nils-eilers/kolibri/README.md

kolibri
=======

About
-----

kolibri is an 8 bit homebrew computer project, based on the 6309 CPU by
Hitachi, a kind of advanced edition of the much more famous CPU 6809 by
Motorola.

kolibri is the german word for colibri aka hummingbird.
