nils-eilers/kolibri/software/i8742/README.md

8742 keyboard and mouse controller for kolibri
==============================================

Assemble with The Macroassembler AS, freely available from http://john.ccac.rwth-aachen.de:8000/as/

Based on disassembly of 72x8455.zm82.bin

Commented disassembly of the PS/2 keyboard/auxiliary device controller 8042
2KB ROM by A. Tarpai 2018 (Questions & comments are welcome to tarpai76 at gmail)

The original file has been downloaded from http://www.halicery.com/8042/8042_PS2_INTERN.TEXT
