nils-eilers/kolibri/doc/jtag-chain.png

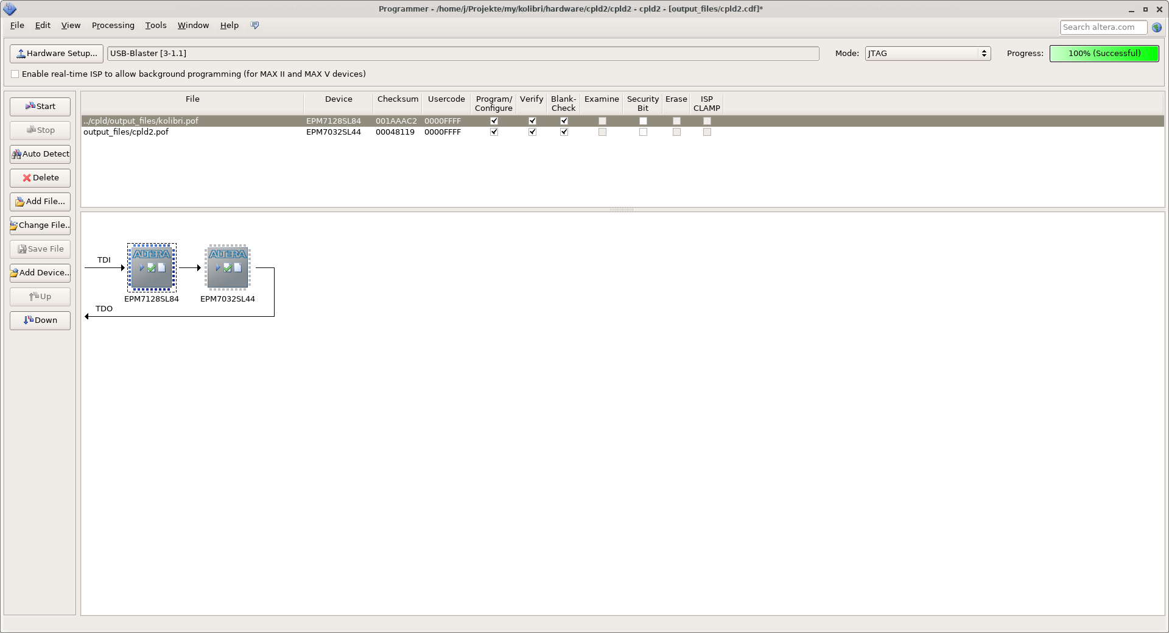
doc/jtag-chain.png
