nils-eilers/kolibri/doc/manual/bios.tex

\chapter{BIOS}

\section{Introduction}

The BIOS functions are called via software interrupt {\bf SWI}.
Input and output parameters are transferred via registers.
The contents of all registers are retained, except those,
which are used to return values.

Register {\bf B} is loaded with the BIOS function number.
Never use numeric values to load the {\bf B} register.
Use the symbolic names, as defined in the file
"kolibri-definitions.as9".

If more byte values are needed as input, the registers
{\bf A}, {\bf E} and {\bf F} may be used.
16-bit values or addresses can be loaded into the registers
{\bf X} or {\bf Y}.

If the number of parameters exceeds the number of available
registers, the address of a structure should be passed.

Examples:
\begin{verbatim}

*       print the character 'A'

        LDB   #SCR_Put_Char
        LDA   #'A'
        SWI

*       print a zero terminated string

        LDB   #SCR_Put_String
        LDX   #Message
        SWI

*       Read a character from keyboard

        LDB   #KBD_Get_Key
        SWI
*             Register A now contains an ASCII value
*             or NULL, if no key was read
        RTS

Message BYTE "Kolibri welcomes you\n",0

\end{verbatim}
