nils-eilers/kolibri/doc/manual/frontcover.tex

\begin{titlepage}
\begin{center}
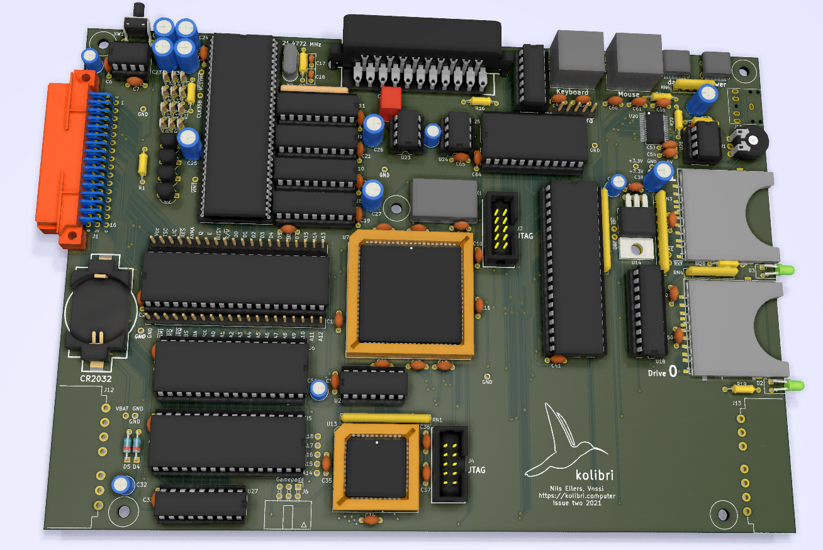
[picture p2: doc/manual/images/cover.png]

\end{center}
\end{titlepage}
