nils-eilers/kolibri/doc/manual/images/cpld-jtag-programming.png

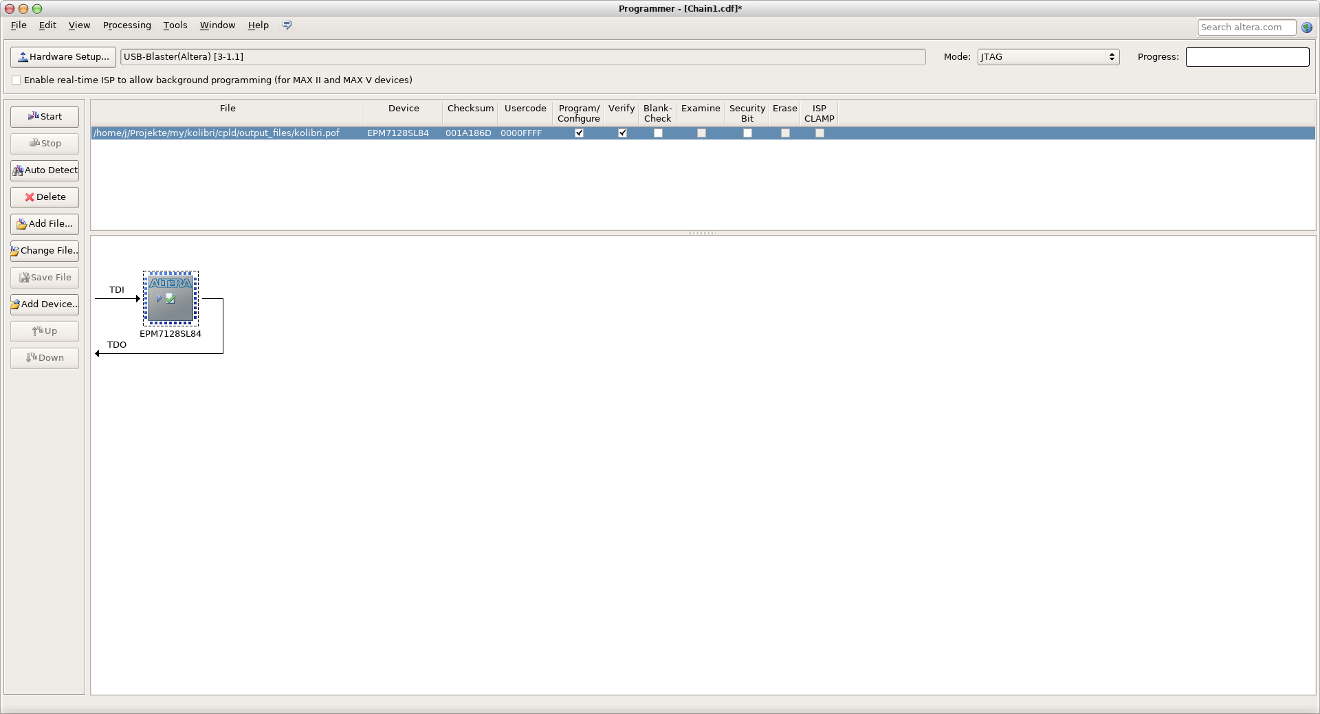
doc/manual/images/cpld-jtag-programming.png
