nils-eilers/kolibri/doc/manual/images/mini.jpg

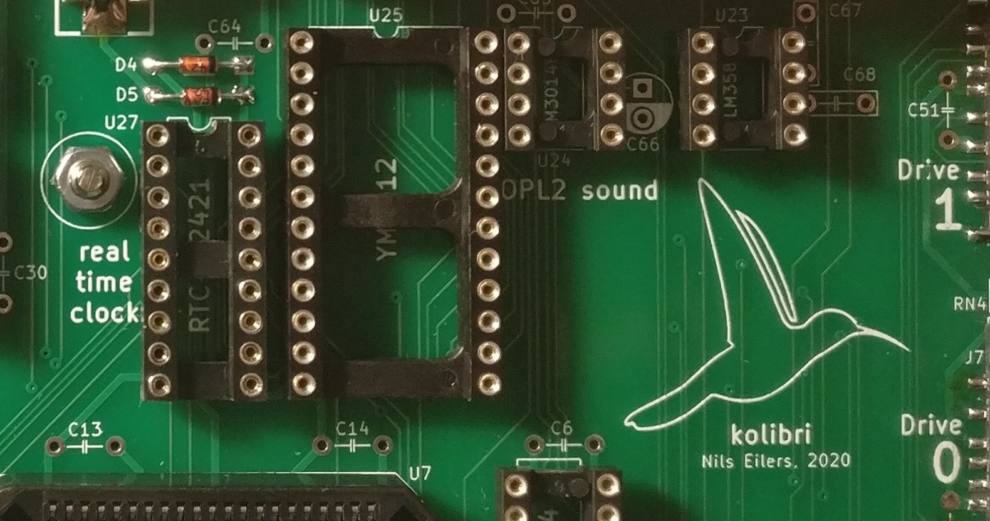
doc/manual/images/mini.jpg
