nils-eilers/kolibri/doc/kolibri-issue-three-schematics.pdf

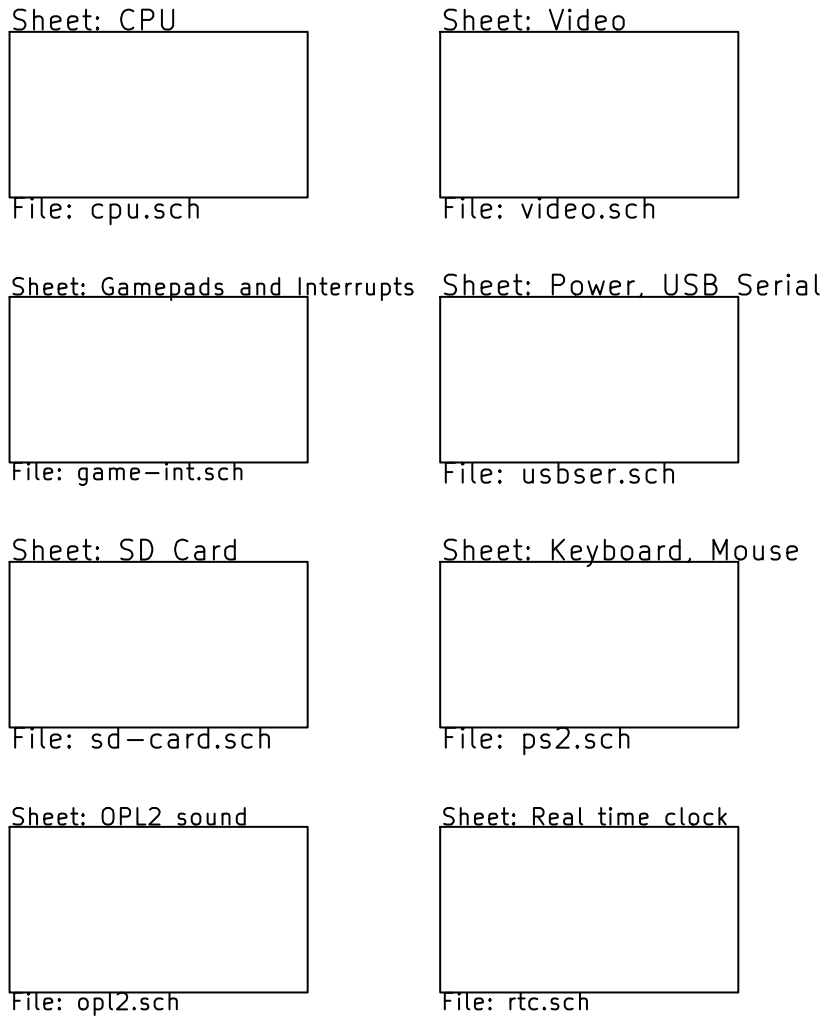
[picture p14: page 1]

File: game-int.sch

Id: 1/9 Title: kolibri File: main.sch Sheet: / nils.eilers@gmx.de

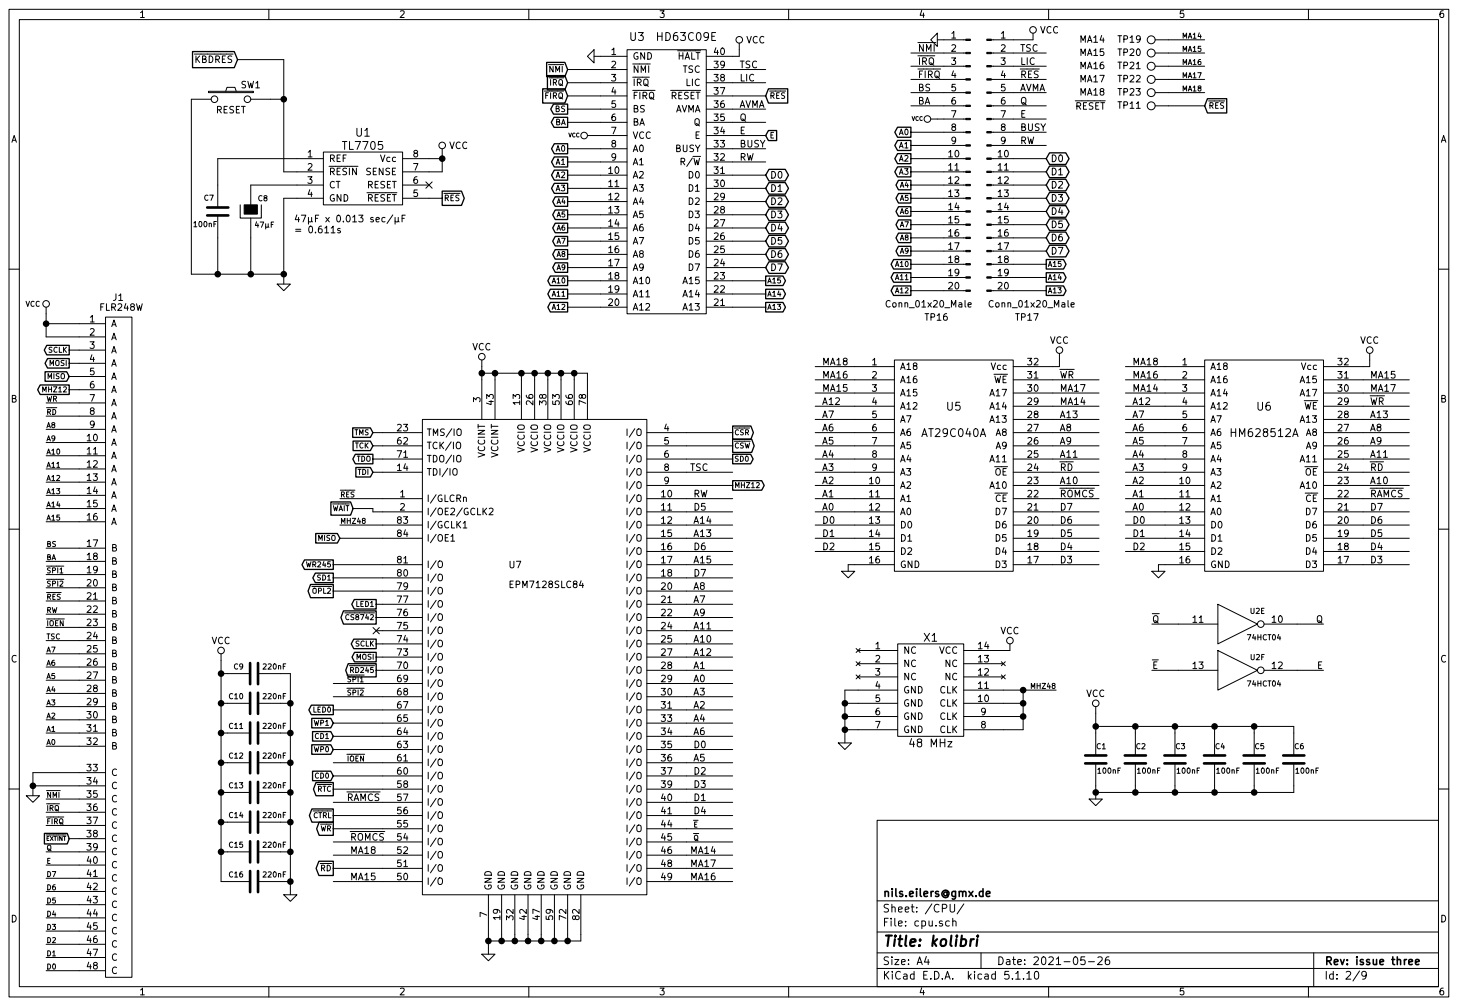
[picture p15: page 2]

File: cpu.sch Sheet: /CPU/ nils.eilers@gmx.de

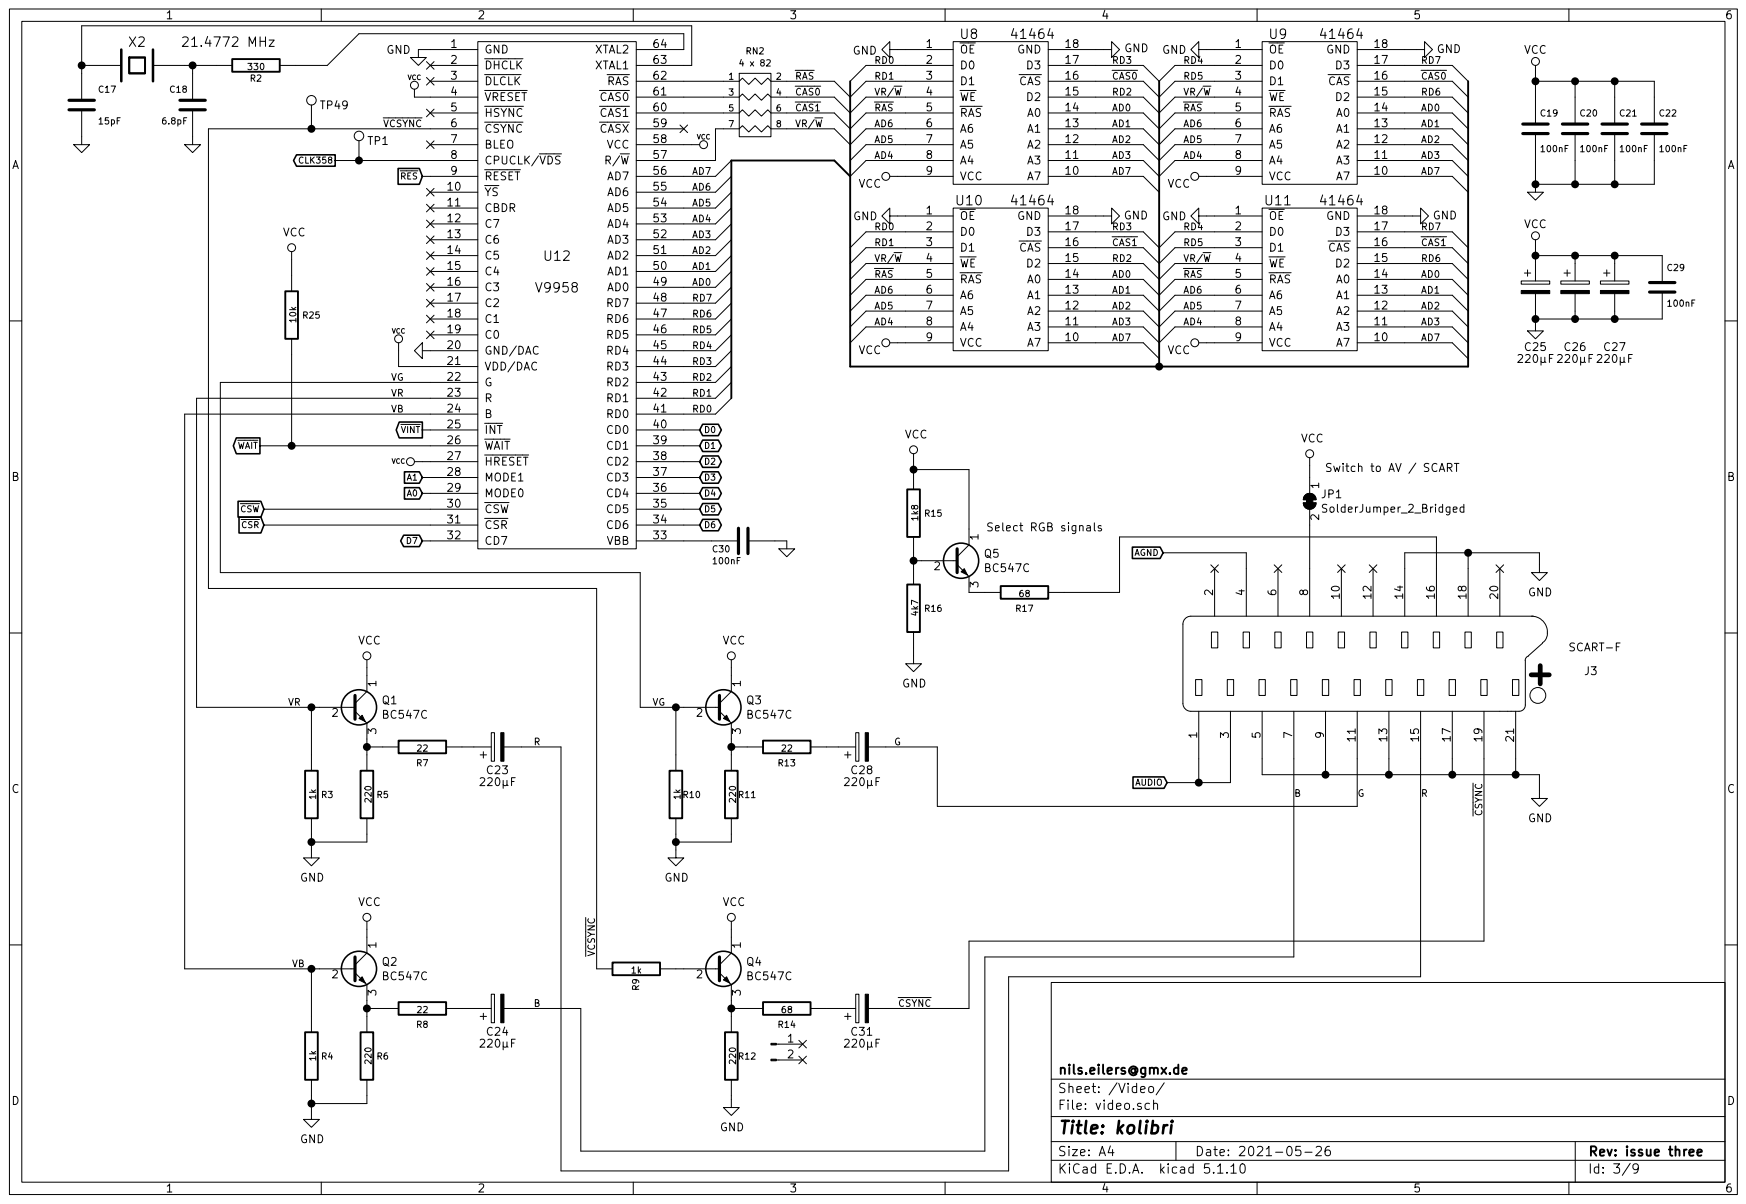
[picture p16: page 3]

VR
VB 24

Id: 3/9 Title: kolibri File: video.sch Sheet: /Video/ nils.eilers@gmx.de

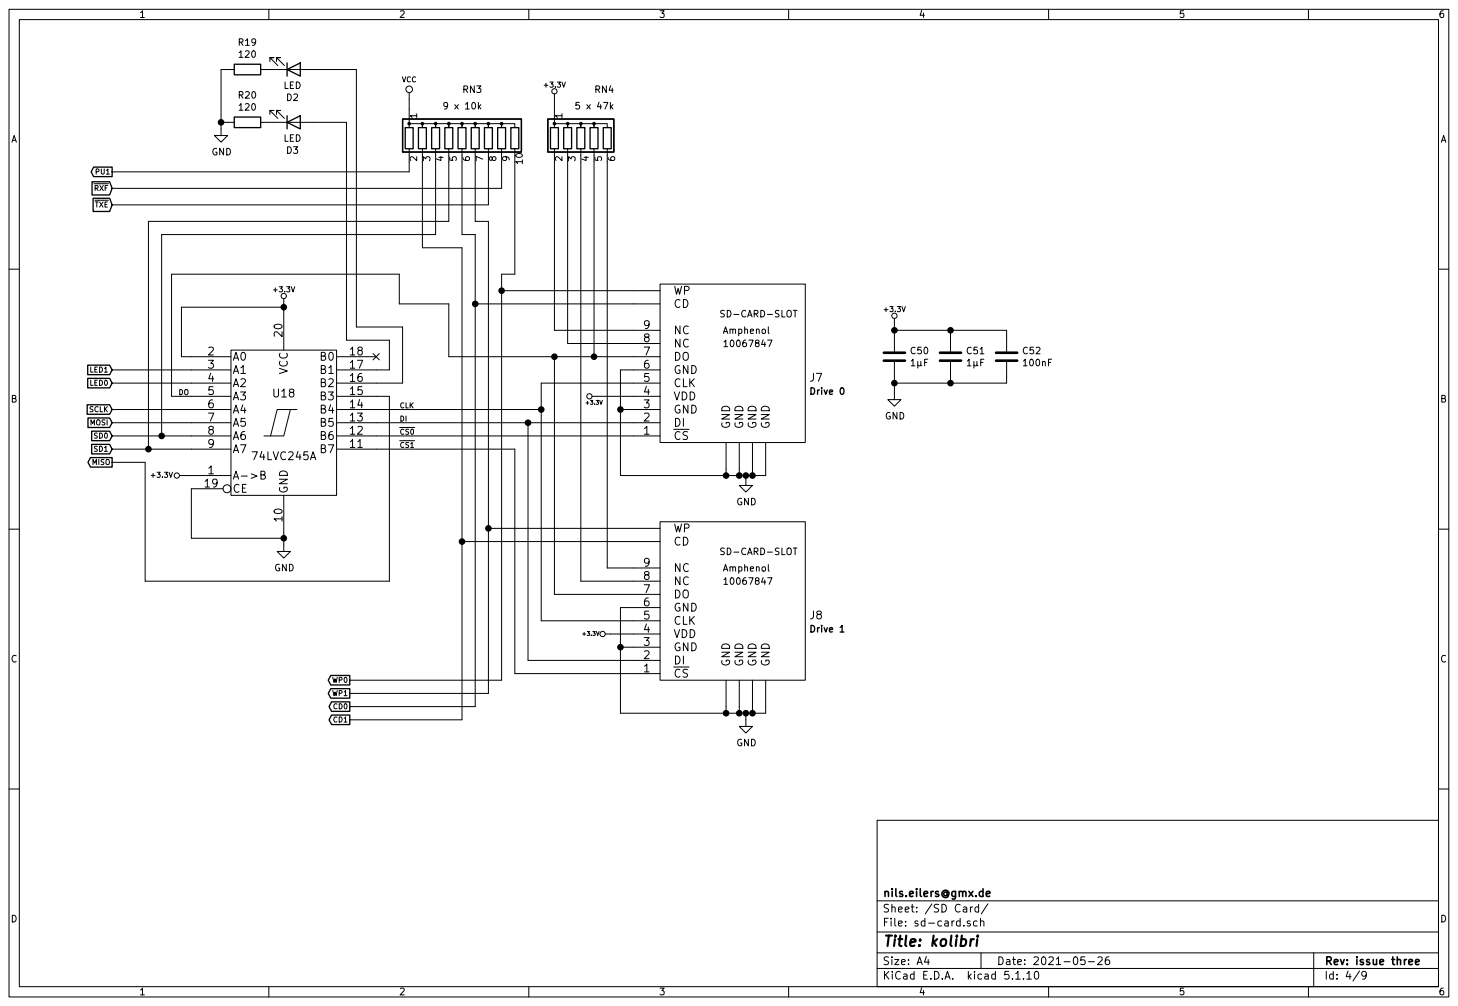
[picture p17: page 4]

Id: 4/9 Title: kolibri File: sd-card.sch Sheet: /SD Card/ nils.eilers@gmx.de

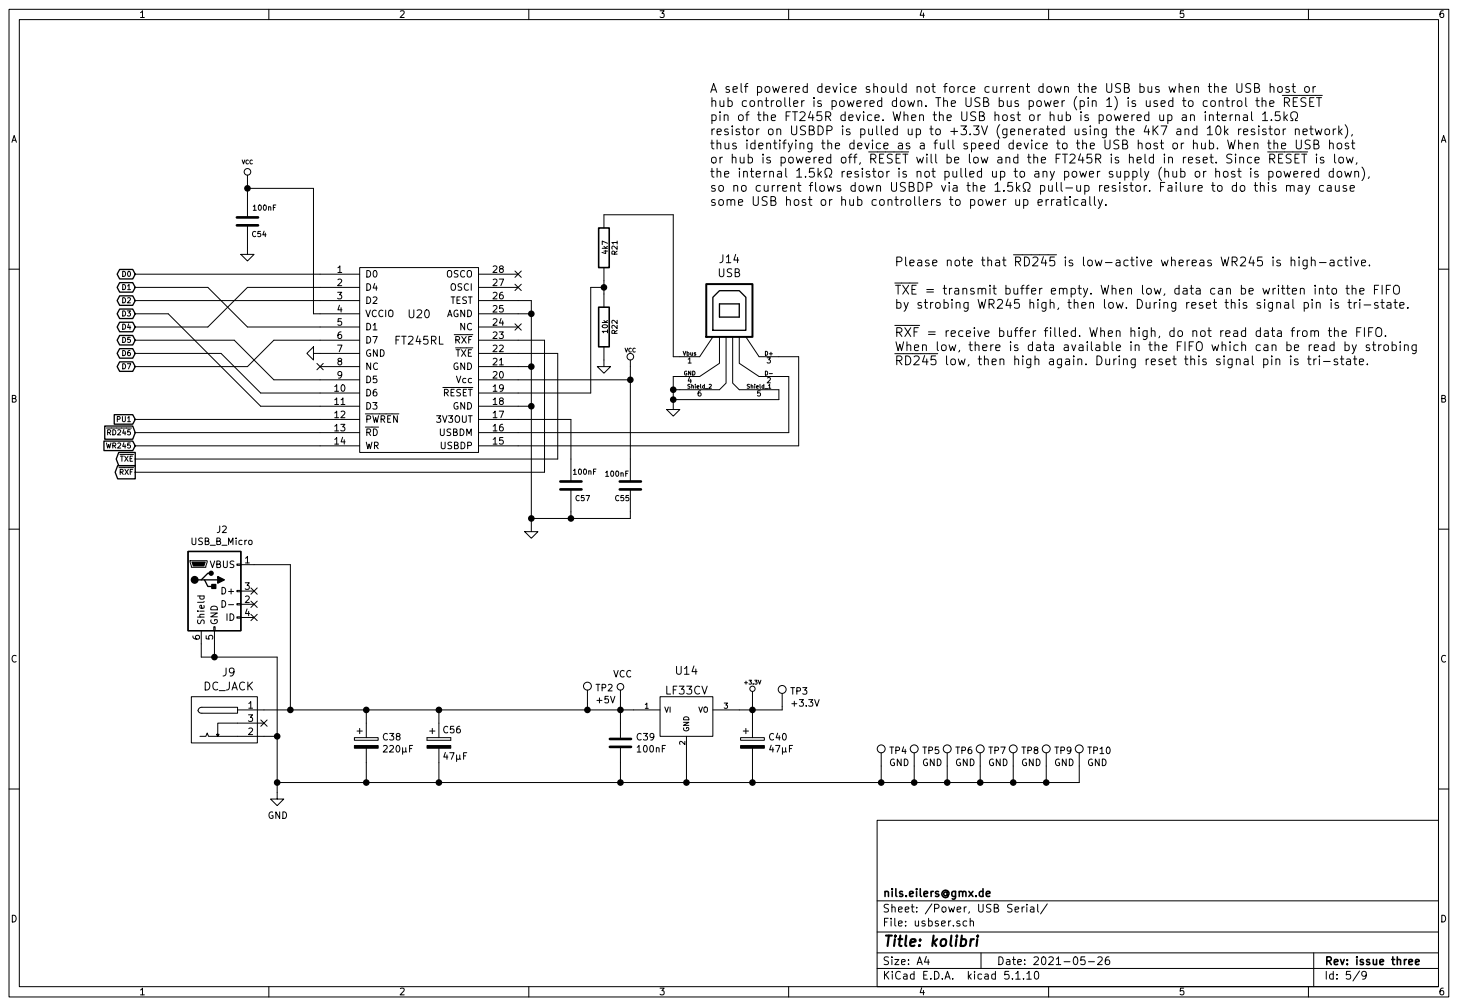
[picture p18: page 5]

hub controller is powered down. The USB bus power (pin 1) is used to control the RESET
pin of the FT245R device. When the USB host or hub is powered up an internal 1.5k
resistor on USBDP is pulled up to +3.3V (generated using the 4K7 and 10k resistor network),
thus identifying the device as a full speed device to the USB host or hub. When the USB host
or hub is powered off, RESET will be low and the FT245R is held in reset. Since RESET is low,
the internal 1.5k resistor is not pulled up to any power supply (hub or host is powered down),
so no current flows down USBDP via the 1.5k pull-up resistor. Failure to do this may cause
some USB host or hub controllers to power up erratically.

Please note that RD245 is low-active whereas WR245 is high-active.

TXE = transmit buffer empty. When low, data can be written into the FIFO
by strobing WR245 high, then low. During reset this signal pin is tri-state.

RXF = receive buffer filled. When high, do not read data from the FIFO.
When low, there is data available in the FIFO which can be read by strobing
RD245 low, then high again. During reset this signal pin is tri-state.

nils.eilers@gmx.de C56

Id: 5/9 Title: kolibri File: usbser.sch Sheet: /Power, USB Serial/

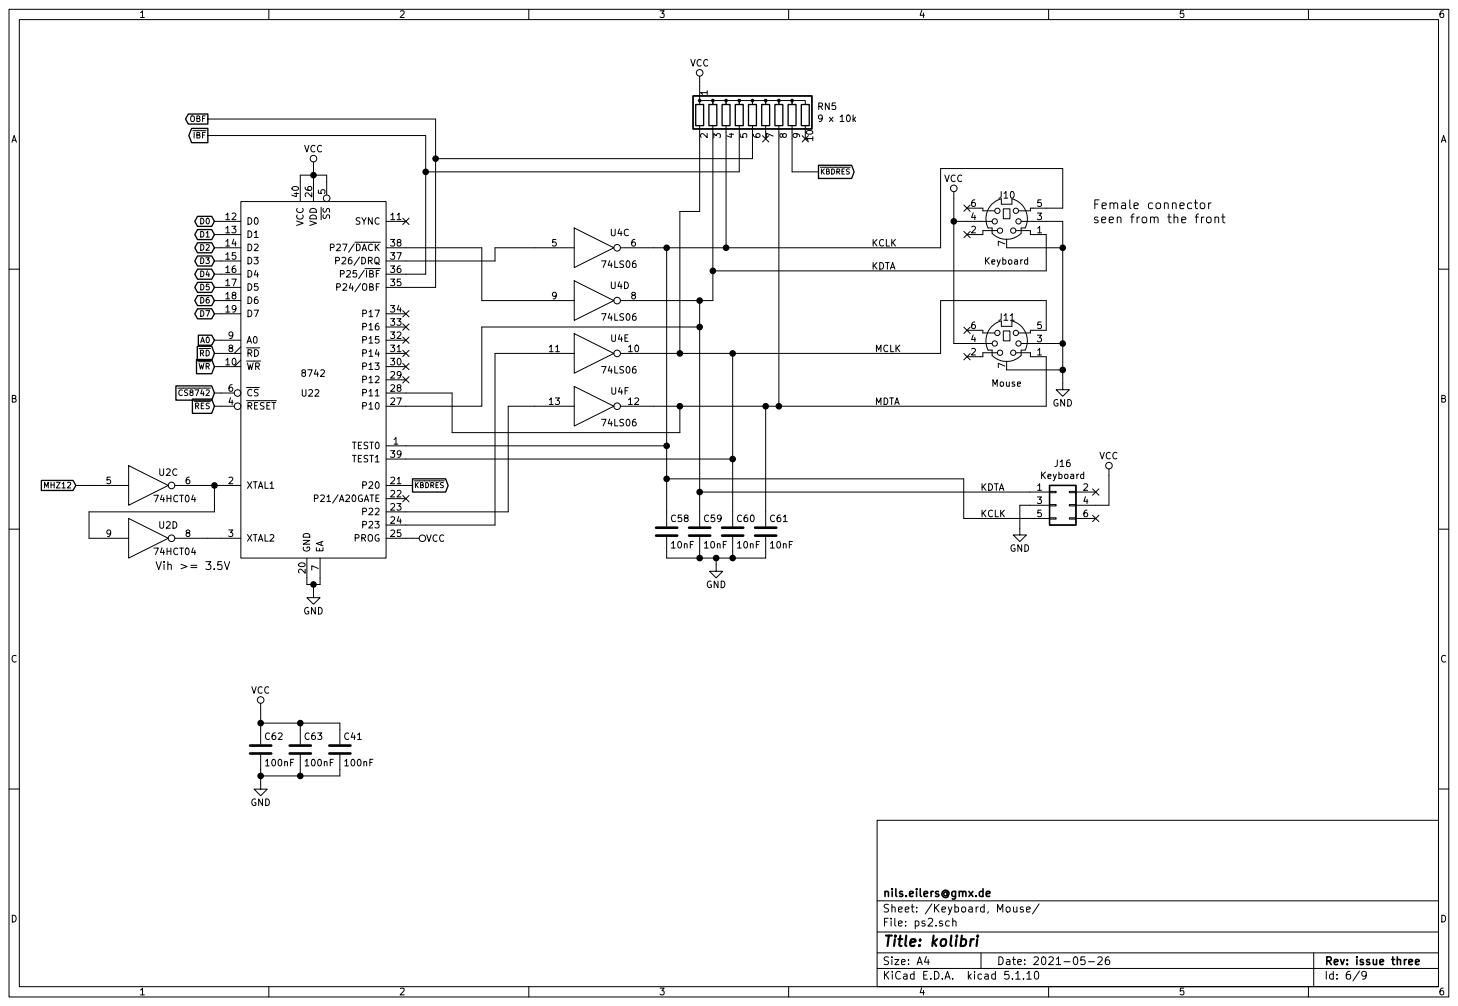
[picture p19: page 6]

seen from the front Vih >= 3.5V
KBDRES D0 CS8742

nils.eilers@gmx.de GND GND

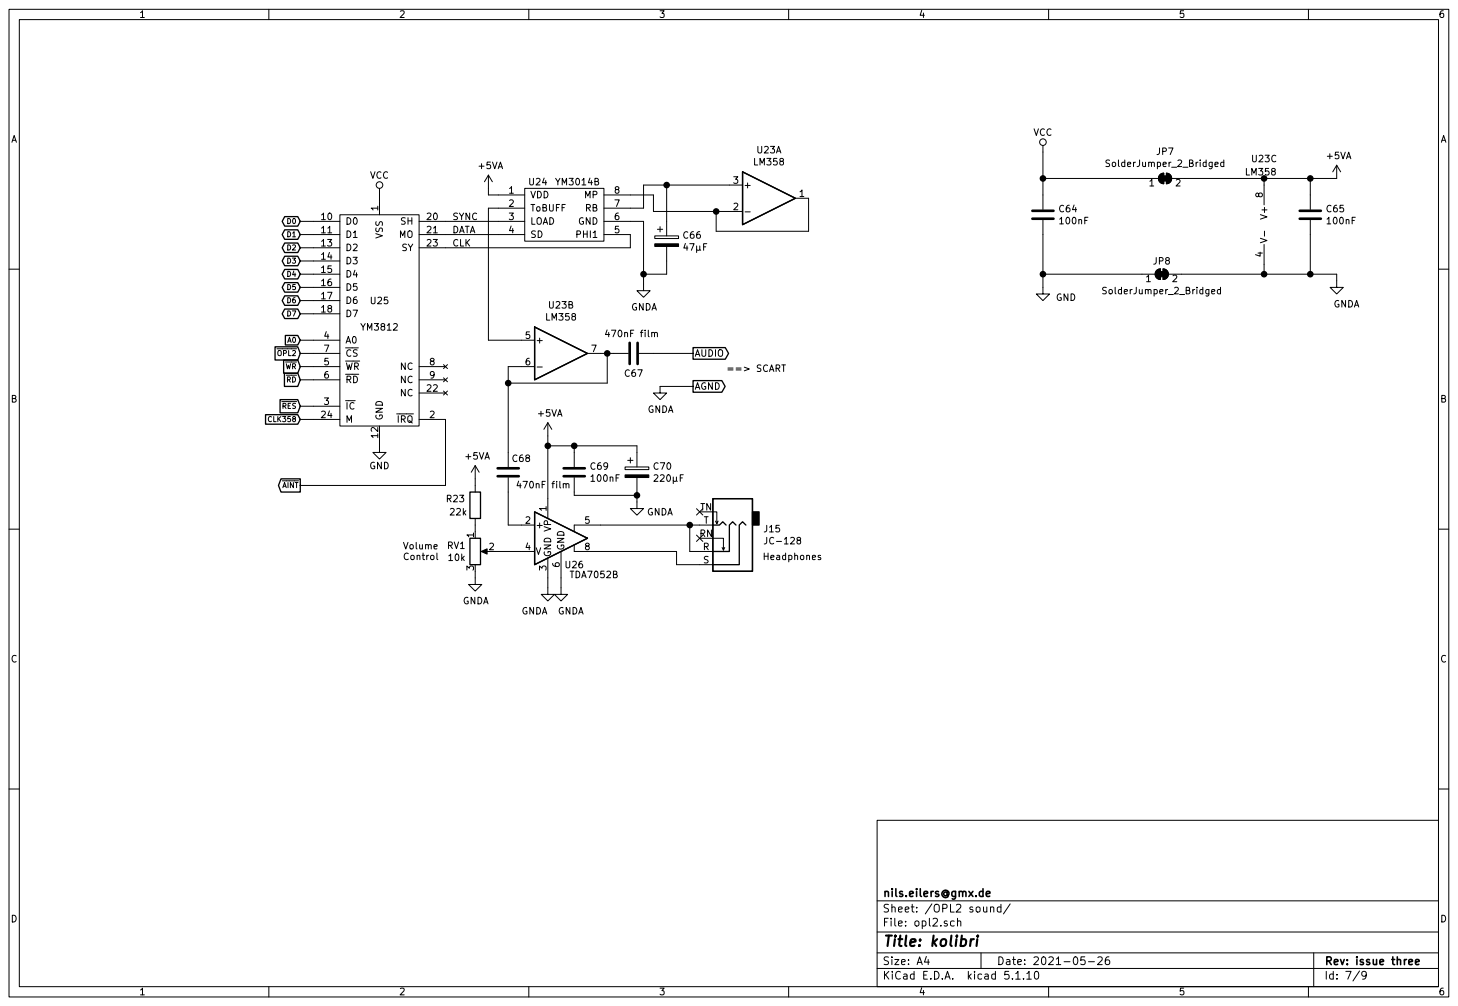
[picture p20: page 7]

File: opl2.sch Sheet: /OPL2 sound/ nils.eilers@gmx.de R

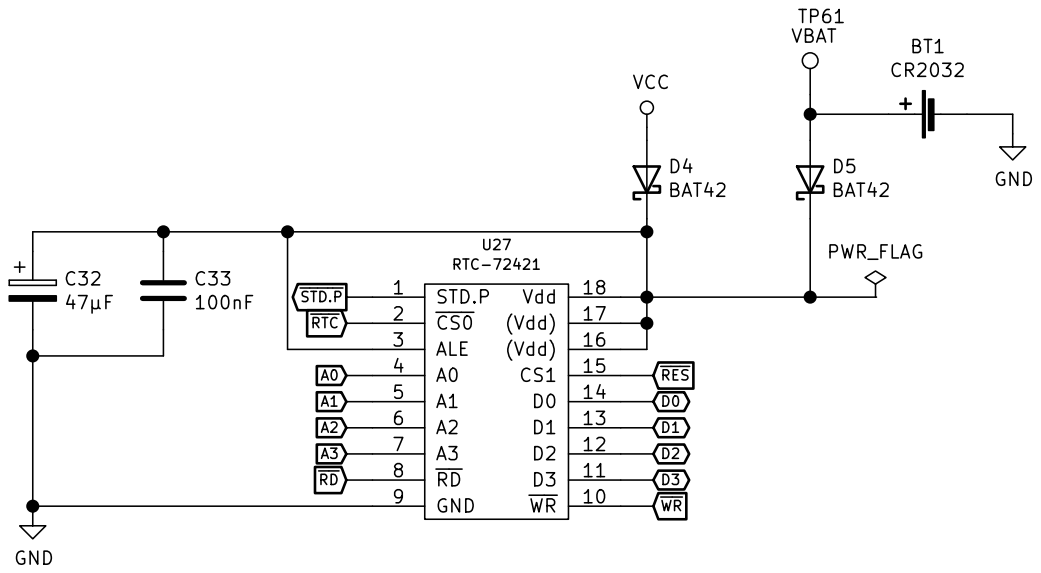
[picture p21: page 8]

Id: 8/9 Title: kolibri File: rtc.sch Sheet: /Real time clock/ nils.eilers@gmx.de

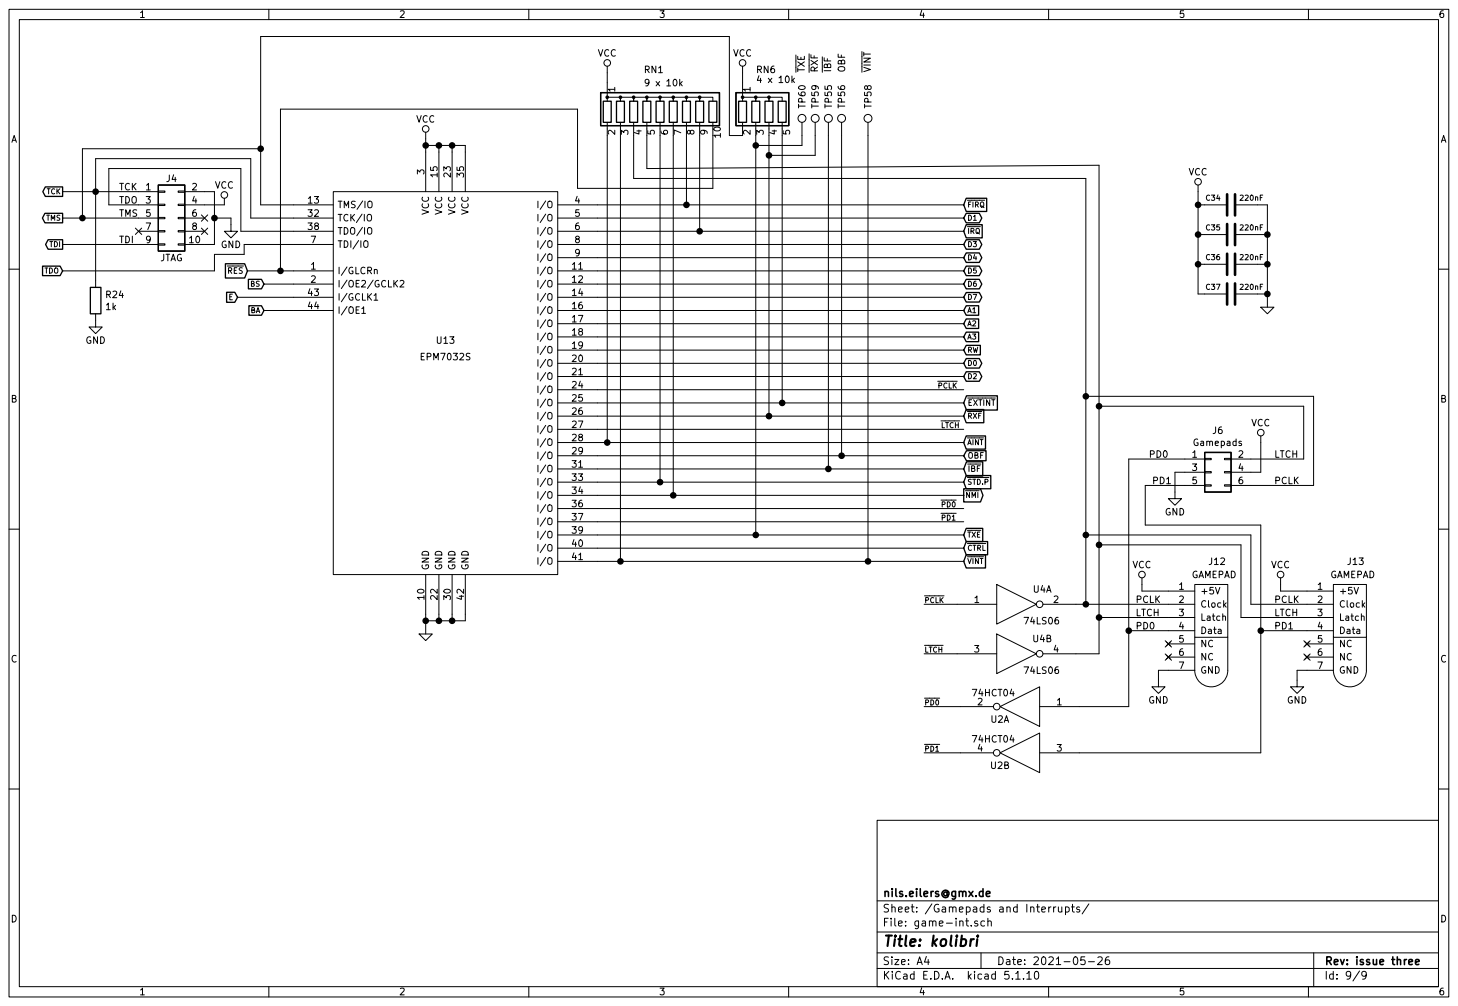
[picture p22: page 9]

nils.eilers@gmx.de
Sheet: /Gamepads and Interrupts/
File: game-int.sch
Id: 9/9 Title: kolibri
