nils-eilers/kolibri/hardware/kicad/main.kicad_pcb

## KiCad design hardware/kicad/main.kicad_pcb (2021-05-25)

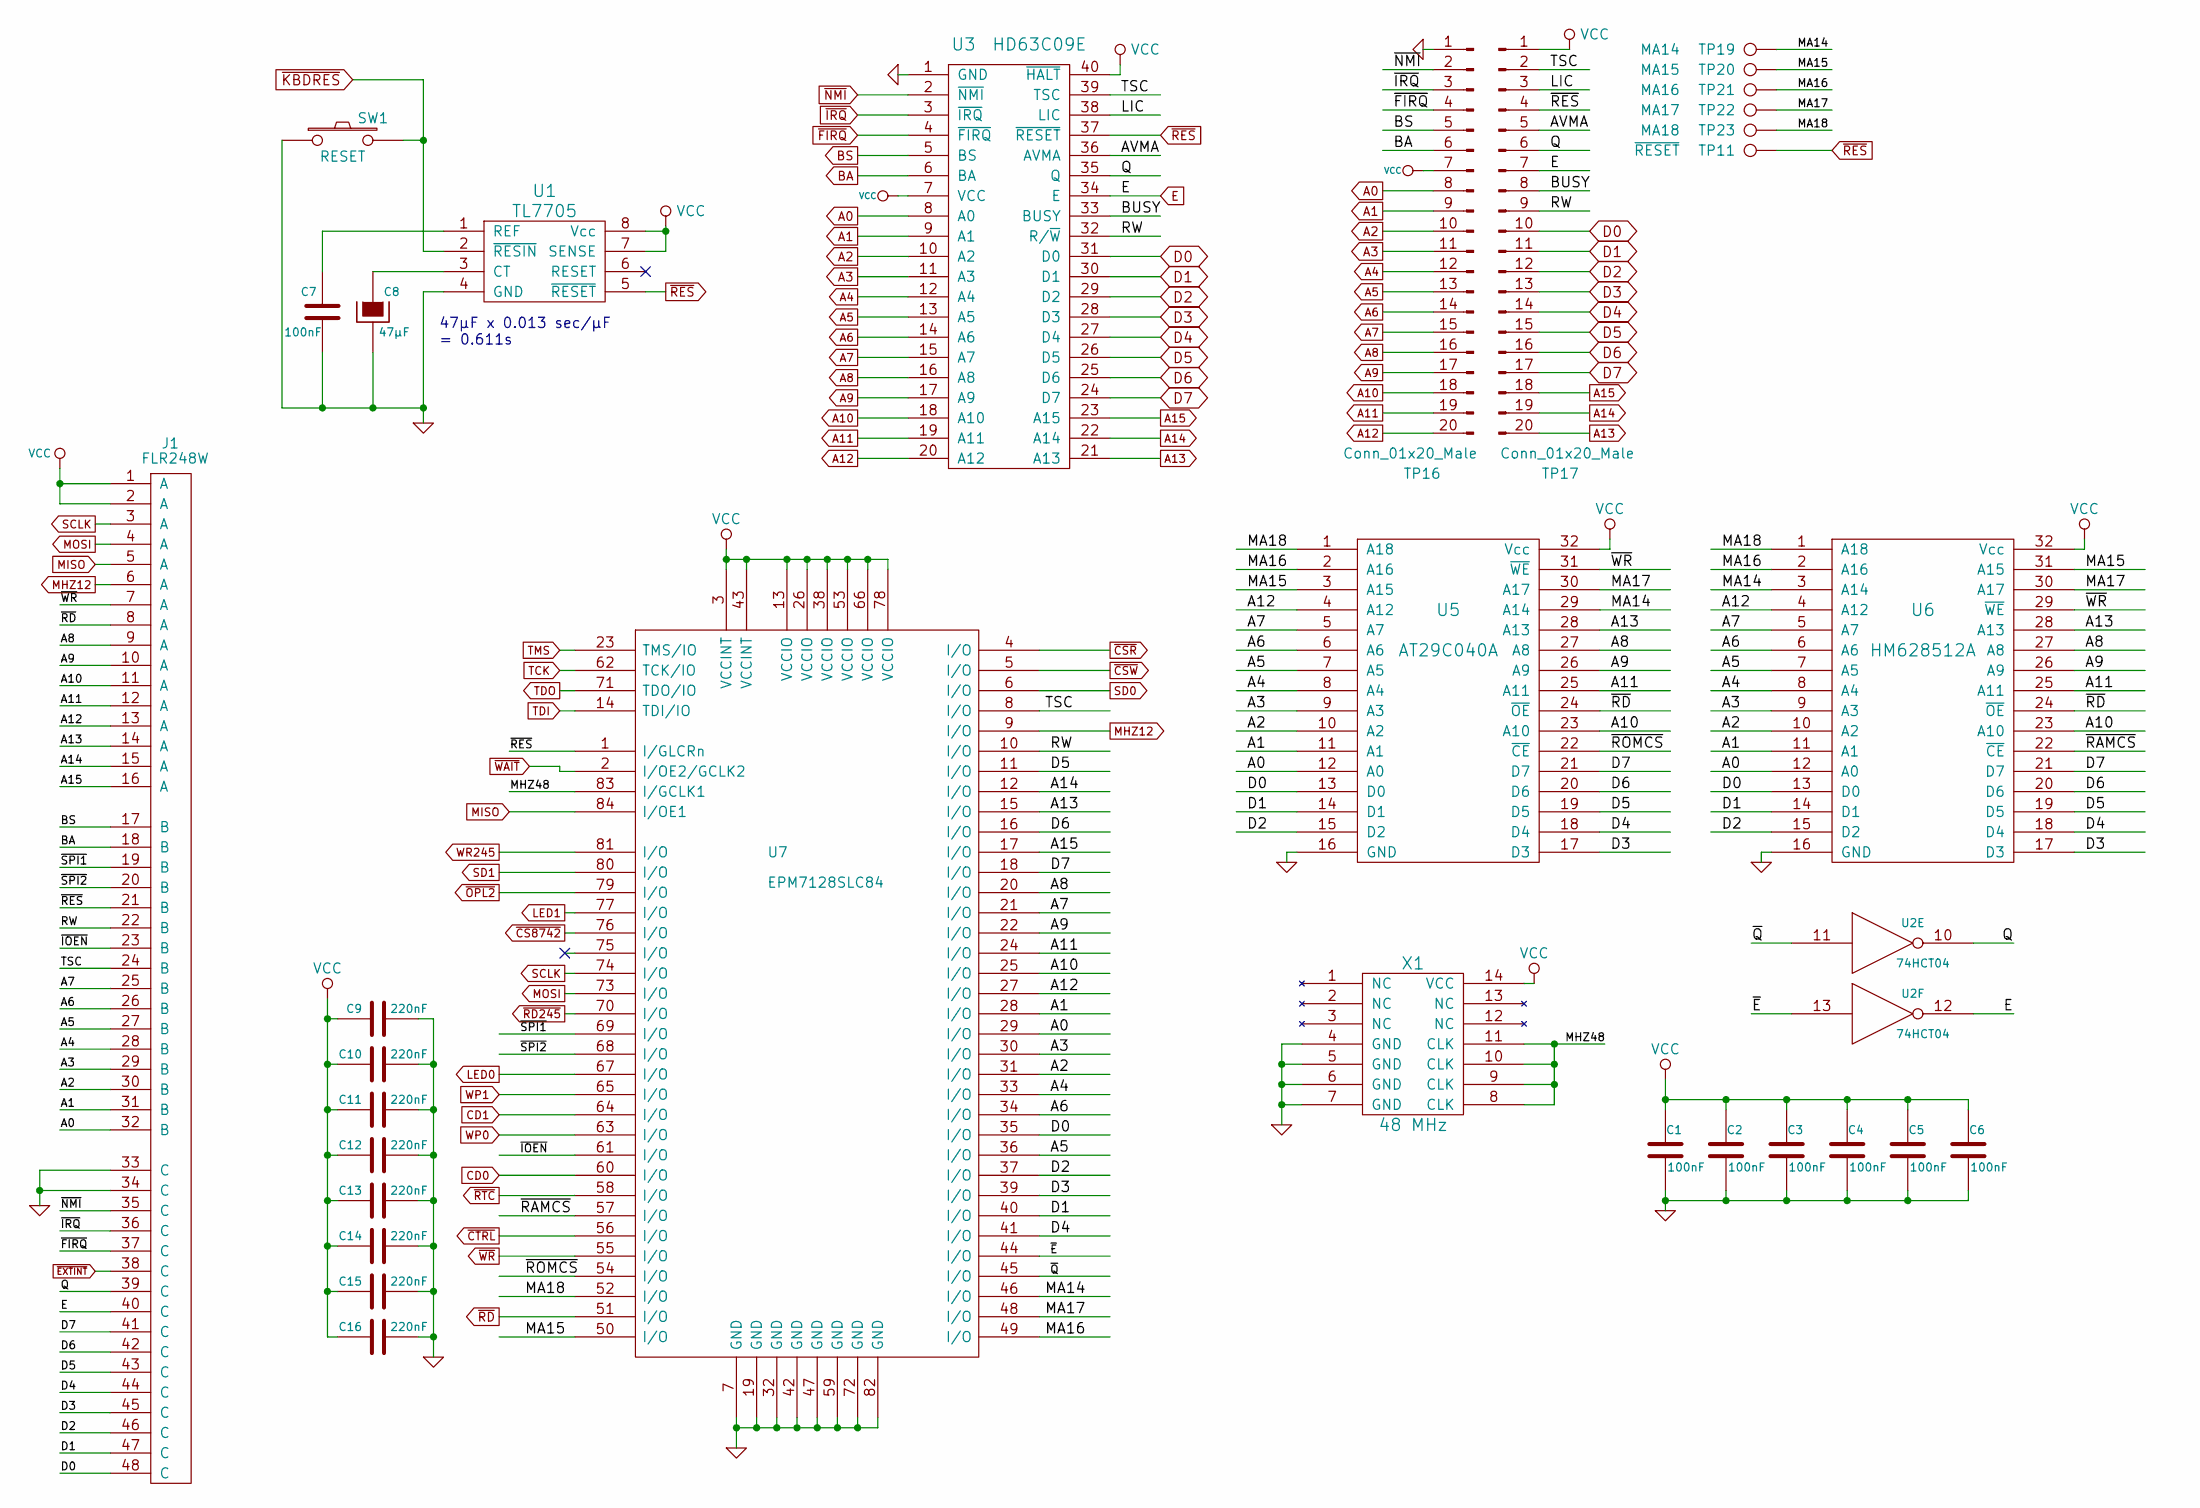
[picture p23: schematic cpu.sch, https://kolibri.computer]

Parts:
C1, C2, C3, C4, C5, C6, C7: 100nF; KERKO-5
C8: 47µF; CP-2-5
C9, C10, C11, C12, C13, C14, C15, C16: 220nF; KERKO-5
J1: FLR248W; FL-R2-48W
SW1: RESET; TASTER_3305
TP11: ~RESET; PINTST
TP16, TP17: Conn_01x20_Male; Pin_Header_Straight_1x20_Pitch2.54mm
TP19: MA14; PINTST
TP20: MA15; PINTST
TP21: MA16; PINTST
TP22: MA17; PINTST
TP23: MA18; PINTST
U1: TL7705; DIP-8
U2: 74HCT04; DIP-14
U3: HD63C09E; DIP-40
U5: AT29C040A; DIP-32
U6: HM628512A; DIP-32
U7: EPM7128SLC84; PLCC-84
X1: 48 MHz; OSC

Connections:
/CPU/AVMA: TP17.5, U3.36 (AVMA)
/CPU/BUSY: TP17.8, U3.33 (BUSY)
/CPU/LIC: TP17.3, U3.38 (LIC)
/CPU/MA14: TP19.1, U5.29 (A14), U6.3 (A14), U7.46 (I/O)
/CPU/MA15: TP20.1, U5.3 (A15), U6.31 (A15), U7.50 (I/O)
/CPU/MA16: TP21.1, U5.2 (A16), U6.2 (A16), U7.49 (I/O)
/CPU/MA17: TP22.1, U5.30 (A17), U6.30 (A17), U7.48 (I/O)
/CPU/MA18: TP23.1, U5.1 (A18), U6.1 (A18), U7.52 (I/O)
/CPU/MHZ48: U7.83 (I/GCLK1), X1.8 (CLK), X1.9 (CLK), X1.10 (CLK), X1.11 (CLK)
/CPU/Q: J1.39 (C), TP17.6, U2.10, U3.35 (Q)
/CPU/RW: J1.22 (B), TP17.9, U3.32 (R/~W), U7.10 (I/O)
/CPU/TSC: J1.24 (B), TP17.2, U3.39 (TSC), U7.8 (I/O)
/CPU/~E: U2.13, U7.44 (I/O)
/CPU/~IOEN: J1.23 (B), U7.61 (I/O)
/CPU/~Q: U2.11, U7.45 (I/O)
/CPU/~RAMCS: U6.22 (~CE), U7.57 (I/O)
/CPU/~ROMCS: U5.22 (~CE), U7.54 (I/O)
/CPU/~SPI1: J1.19 (B), U7.69 (I/O)
/CPU/~SPI2: J1.20 (B), U7.68 (I/O)
A0: J1.32 (B), TP16.8, U3.8 (A0), U5.12 (A0), U6.12 (A0), U7.29 (I/O); also elsewhere on the board
A1: J1.31 (B), TP16.9, U3.9 (A1), U5.11 (A1), U6.11 (A1), U7.28 (I/O); also elsewhere on the board
A2: J1.30 (B), TP16.10, U3.10 (A2), U5.10 (A2), U6.10 (A2), U7.31 (I/O); also elsewhere on the board
A3: J1.29 (B), TP16.11, U3.11 (A3), U5.9 (A3), U6.9 (A3), U7.30 (I/O); also elsewhere on the board
A4: J1.28 (B), TP16.12, U3.12 (A4), U5.8 (A4), U6.8 (A4), U7.33 (I/O)
A5: J1.27 (B), TP16.13, U3.13 (A5), U5.7 (A5), U6.7 (A5), U7.36 (I/O)
A6: J1.26 (B), TP16.14, U3.14 (A6), U5.6 (A6), U6.6 (A6), U7.34 (I/O)
A7: J1.25 (B), TP16.15, U3.15 (A7), U5.5 (A7), U6.5 (A7), U7.21 (I/O)
A8: J1.9 (A), TP16.16, U3.16 (A8), U5.27 (A8), U6.27 (A8), U7.20 (I/O)
A9: J1.10 (A), TP16.17, U3.17 (A9), U5.26 (A9), U6.26 (A9), U7.22 (I/O)
A10: J1.11 (A), TP16.18, U3.18 (A10), U5.23 (A10), U6.23 (A10), U7.25 (I/O)
A11: J1.12 (A), TP16.19, U3.19 (A11), U5.25 (A11), U6.25 (A11), U7.24 (I/O)
A12: J1.13 (A), TP16.20, U3.20 (A12), U5.4 (A12), U6.4 (A12), U7.27 (I/O)
A13: J1.14 (A), TP17.20, U3.21 (A13), U5.28 (A13), U6.28 (A13), U7.15 (I/O)
A14: J1.15 (A), TP17.19, U3.22 (A14), U7.12 (I/O)
A15: J1.16 (A), TP17.18, U3.23 (A15), U7.17 (I/O)
BA: J1.18 (B), TP16.6, U3.6 (BA); also elsewhere on the board
BS: J1.17 (B), TP16.5, U3.5 (BS); also elsewhere on the board
CD0: U7.60 (I/O); also elsewhere on the board
CD1: U7.64 (I/O); also elsewhere on the board
D0: J1.48 (C), TP17.10, U3.31 (D0), U5.13 (D0), U6.13 (D0), U7.35 (I/O); also elsewhere on the board
D1: J1.47 (C), TP17.11, U3.30 (D1), U5.14 (D1), U6.14 (D1), U7.40 (I/O); also elsewhere on the board
D2: J1.46 (C), TP17.12, U3.29 (D2), U5.15 (D2), U6.15 (D2), U7.37 (I/O); also elsewhere on the board
D3: J1.45 (C), TP17.13, U3.28 (D3), U5.17 (D3), U6.17 (D3), U7.39 (I/O); also elsewhere on the board
D4: J1.44 (C), TP17.14, U3.27 (D4), U5.18 (D4), U6.18 (D4), U7.41 (I/O); also elsewhere on the board
D5: J1.43 (C), TP17.15, U3.26 (D5), U5.19 (D5), U6.19 (D5), U7.11 (I/O); also elsewhere on the board
D6: J1.42 (C), TP17.16, U3.25 (D6), U5.20 (D6), U6.20 (D6), U7.16 (I/O); also elsewhere on the board
D7: J1.41 (C), TP17.17, U3.24 (D7), U5.21 (D7), U6.21 (D7), U7.18 (I/O); also elsewhere on the board
E: J1.40 (C), TP17.7, U2.12, U3.34 (E); also elsewhere on the board
GND: C1.2, C2.2, C3.2, C4.2, C5.2, C6.2, C7.1, C8.2, C9.2, C10.2, C11.2, C12.2, C13.2, C14.2, C15.2, C16.2, J1.33 (C), J1.34 (C), SW1.1, TP16.1, U1.4 (GND), U2.7 (GND), U3.1 (GND), U5.16 (GND), U6.16 (GND), U7.7 (GND), U7.19 (GND), U7.32 (GND), U7.42 (GND), U7.47 (GND), U7.59 (GND), U7.72 (GND), U7.82 (GND), X1.4 (GND), X1.5 (GND), X1.6 (GND), X1.7 (GND); also elsewhere on the board
LED0: U7.67 (I/O); also elsewhere on the board
LED1: U7.77 (I/O); also elsewhere on the board
MHZ12: J1.6 (A), U7.9 (I/O); also elsewhere on the board
MISO: J1.5 (A), U7.84 (I/OE1); also elsewhere on the board
MOSI: J1.4 (A), U7.73 (I/O); also elsewhere on the board
unnamed: C7.2, U1.1 (REF)
unnamed: C8.1, U1.3 (CT)
SCLK: J1.3 (A), U7.74 (I/O); also elsewhere on the board
SD0: U7.6 (I/O); also elsewhere on the board
SD1: U7.80 (I/O); also elsewhere on the board
TCK: U7.62 (TCK/IO); also elsewhere on the board
TDI: U7.14 (TDI/IO); also elsewhere on the board
TDO: U7.71 (TDO/IO); also elsewhere on the board
TMS: U7.23 (TMS/IO); also elsewhere on the board
VCC: C1.1, C2.1, C3.1, C4.1, C5.1, C6.1, C9.1, C10.1, C11.1, C12.1, C13.1, C14.1, C15.1, C16.1, J1.1 (A), J1.2 (A), TP16.7, TP17.1, U1.7 (SENSE), U1.8 (Vcc), U2.14 (VCC), U3.7 (VCC), U3.40 (~HALT), U5.32 (Vcc), U6.32 (Vcc), U7.3 (VCCINT), U7.13 (VCCIO), U7.26 (VCCIO), U7.38 (VCCIO), U7.43 (VCCINT), U7.53 (VCCIO), U7.66 (VCCIO), U7.78 (VCCIO), X1.14 (VCC); also elsewhere on the board
WP0: U7.63 (I/O); also elsewhere on the board
WP1: U7.65 (I/O); also elsewhere on the board
WR245: U7.81 (I/O); also elsewhere on the board
~CS8742: U7.76 (I/O); also elsewhere on the board
~CSR: U7.4 (I/O); also elsewhere on the board
~CSW: U7.5 (I/O); also elsewhere on the board
~CTRL: U7.56 (I/O); also elsewhere on the board
~EXTINT: J1.38 (C); also elsewhere on the board
~FIRQ: J1.37 (C), TP16.4, U3.4 (~FIRQ); also elsewhere on the board
~IRQ: J1.36 (C), TP16.3, U3.3 (~IRQ); also elsewhere on the board
~KBDRES: SW1.2, U1.2 (~RESIN); also elsewhere on the board
~NMI: J1.35 (C), TP16.2, U3.2 (~NMI); also elsewhere on the board
~OPL2: U7.79 (I/O); also elsewhere on the board
~RD: J1.8 (A), U5.24 (~OE), U6.24 (~OE), U7.51 (I/O); also elsewhere on the board
~RD245: U7.70 (I/O); also elsewhere on the board
~RES: J1.21 (B), TP11.1, TP17.4, U1.5 (~RESET), U3.37 (~RESET), U7.1 (I/GLCRn); also elsewhere on the board
~RTC: U7.58 (I/O); also elsewhere on the board
~WAIT: U7.2 (I/OE2/GCLK2); also elsewhere on the board
~WR: J1.7 (A), U5.31 (~WE), U6.29 (~WE), U7.55 (I/O); also elsewhere on the board

Notes on the sheet:
47µF x 0.013 sec/µF = 0.611s

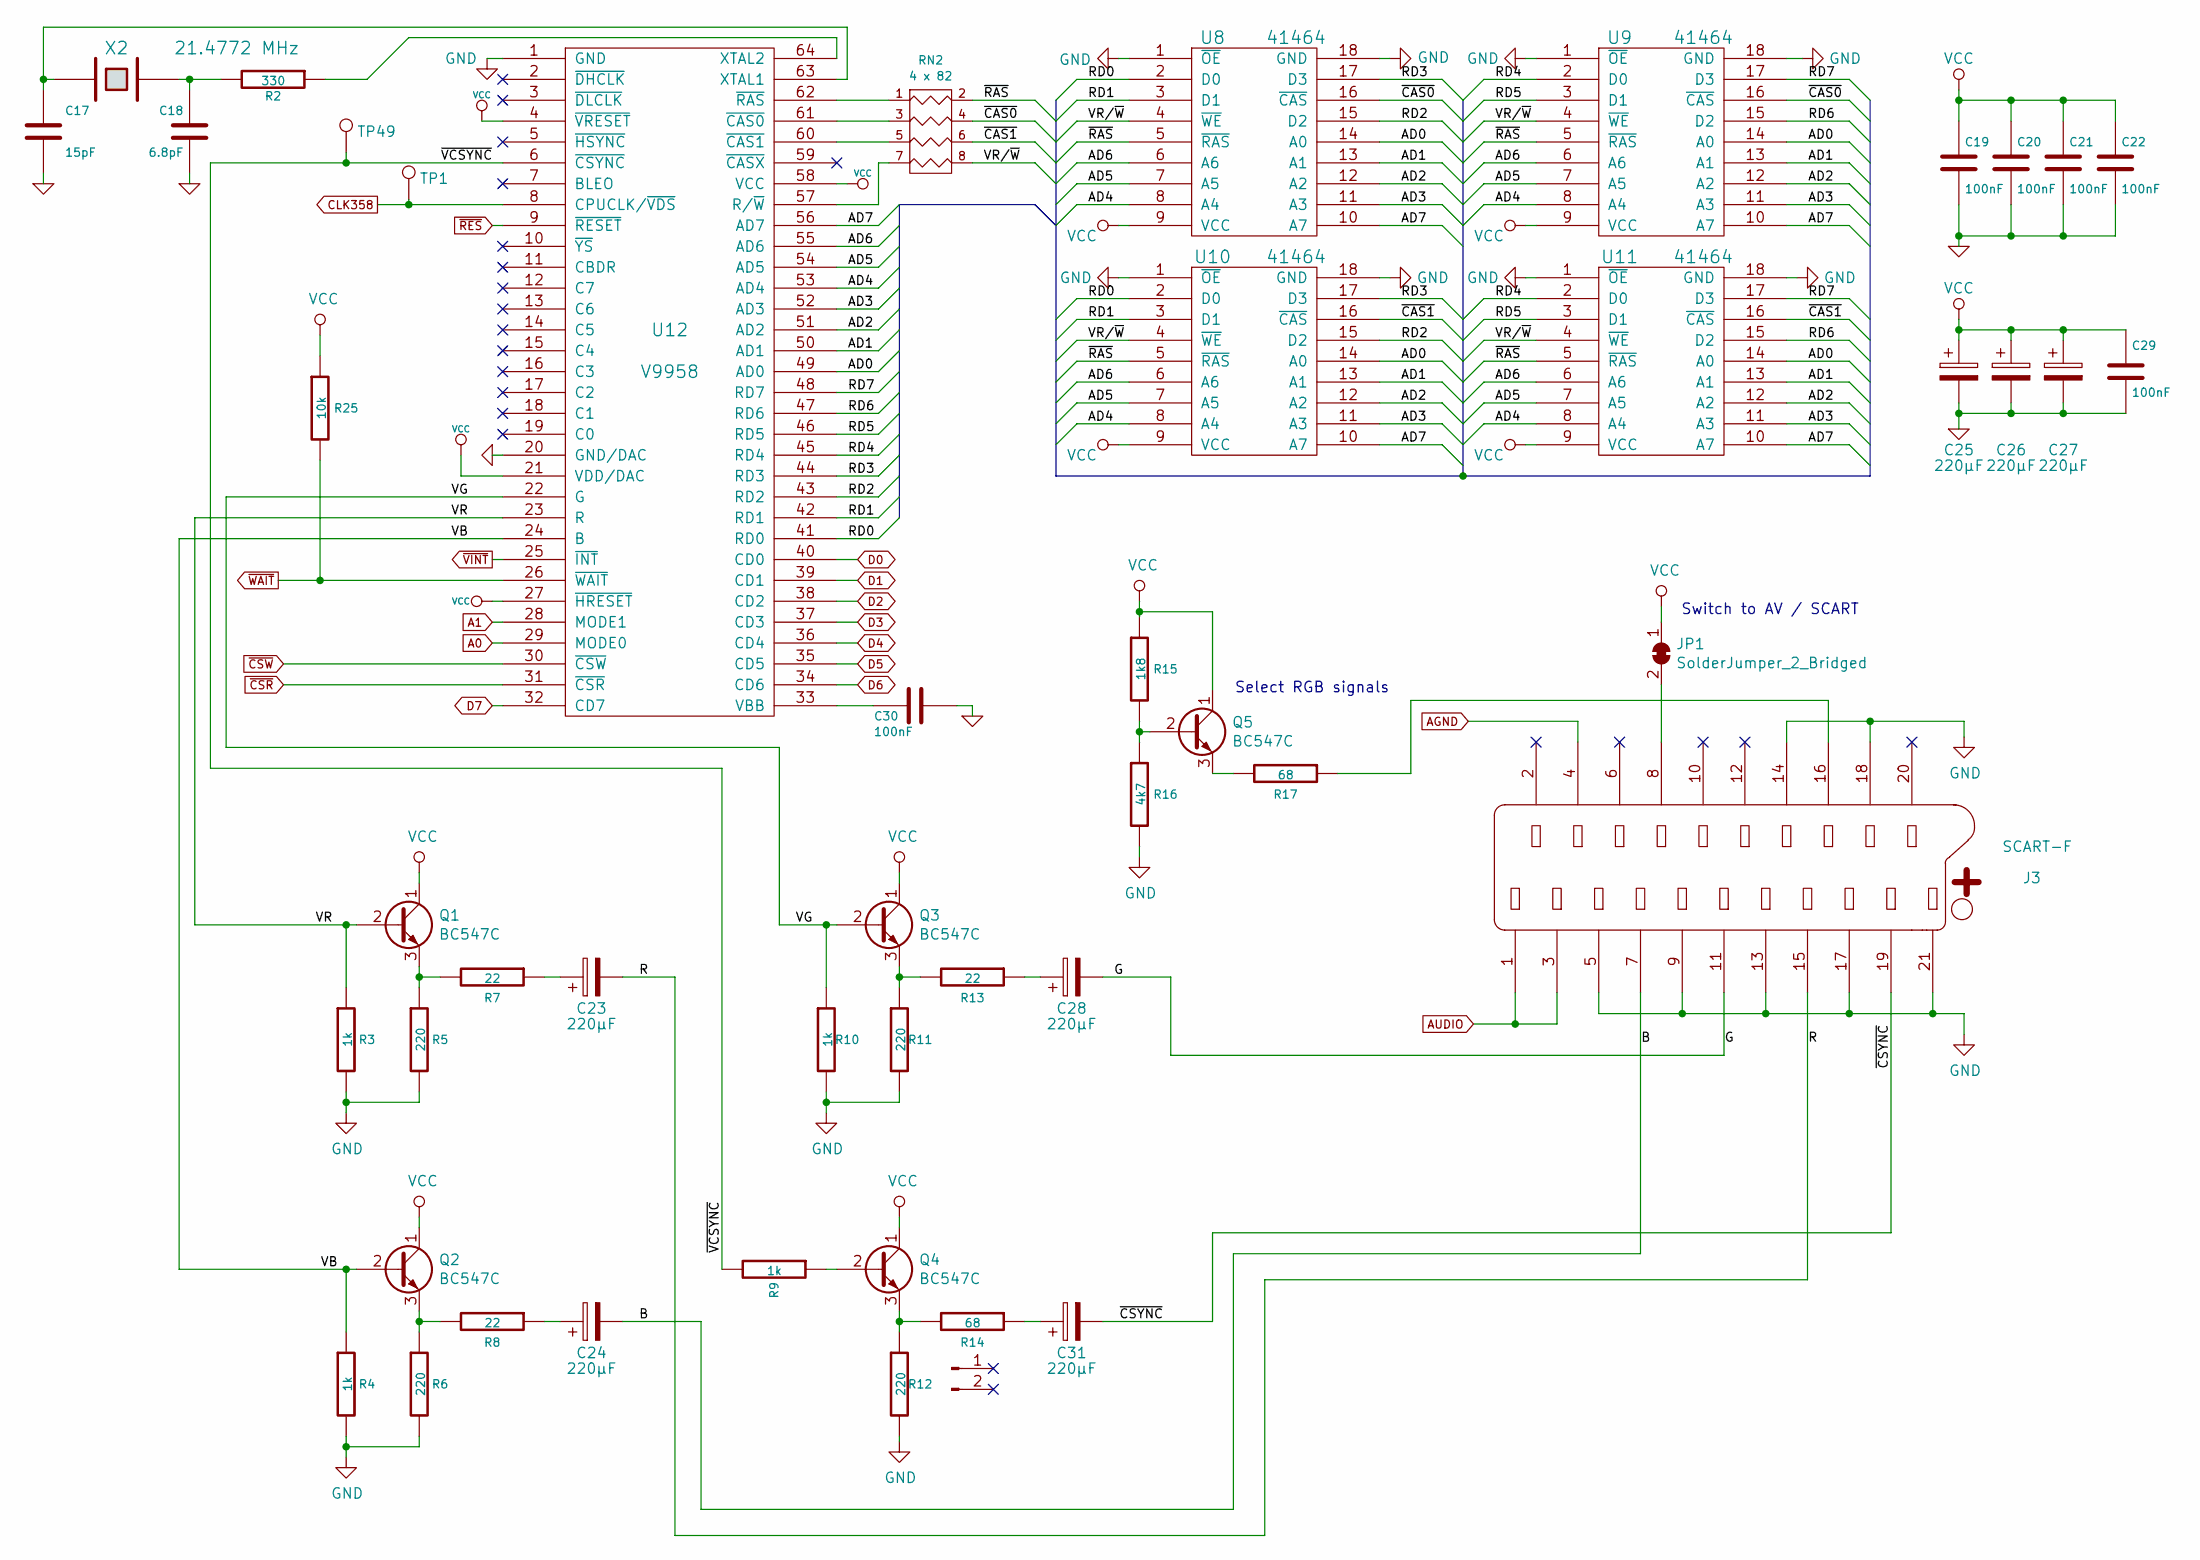
[picture p24: schematic video.sch, kolibri]

Parts:
C17: 15pF; KERKO-2
C18: 6.8pF; KERKO-2
C19, C20, C21, C22, C29, C30: 100nF; KERKO-5
C23, C24, C25, C26, C27, C28, C31: 220µF; CP-2-6
J3: SCART-F; SCART
J5: dummy; R_Axial_DIN0204_L3.6mm_D1.6mm_P2.54mm_Vertical
JP1: SolderJumper_2_Bridged; SolderJumper-2_P1.3mm_Bridged_RoundedPad1.0x1.5mm
Q1, Q2, Q3, Q4, Q5: BC547C; TO-92_Inline_Wide
R2: 330; R
R3, R4, R9, R10: 1k; R_Axial_DIN0204_L3.6mm_D1.6mm_P2.54mm_Vertical
R5, R6, R11, R12: 220; R_Axial_DIN0204_L3.6mm_D1.6mm_P2.54mm_Vertical
R7, R8, R13: 22; R_Axial_DIN0204_L3.6mm_D1.6mm_P2.54mm_Vertical
R14, R17: 68; R
R15: 1k8; R
R16: 4k7; R
R25: 10k; R
RN2: 4 x 82; R_Array_SIP8
TP1: CLK358; PINTST
TP49: ~VCSYNC; PINTST
U8, U9, U10, U11: 41464; DIP-18
U12: V9958; SDIL-64
X2: 21.4772 MHz; CRYSTAL-HC49U

Connections:
/Video/AD0: U8.14 (A0), U9.14 (A0), U10.14 (A0), U11.14 (A0), U12.49 (AD0)
/Video/AD1: U8.13 (A1), U9.13 (A1), U10.13 (A1), U11.13 (A1), U12.50 (AD1)
/Video/AD2: U8.12 (A2), U9.12 (A2), U10.12 (A2), U11.12 (A2), U12.51 (AD2)
/Video/AD3: U8.11 (A3), U9.11 (A3), U10.11 (A3), U11.11 (A3), U12.52 (AD3)
/Video/AD4: U8.8 (A4), U9.8 (A4), U10.8 (A4), U11.8 (A4), U12.53 (AD4)
/Video/AD5: U8.7 (A5), U9.7 (A5), U10.7 (A5), U11.7 (A5), U12.54 (AD5)
/Video/AD6: U8.6 (A6), U9.6 (A6), U10.6 (A6), U11.6 (A6), U12.55 (AD6)
/Video/AD7: U8.10 (A7), U9.10 (A7), U10.10 (A7), U11.10 (A7), U12.56 (AD7)
/Video/B: C24.2, J3.7
/Video/G: C28.2, J3.11
/Video/R: C23.2, J3.15
/Video/RD0: U8.2 (D0), U10.2 (D0), U12.41 (RD0)
/Video/RD1: U8.3 (D1), U10.3 (D1), U12.42 (RD1)
/Video/RD2: U8.15 (D2), U10.15 (D2), U12.43 (RD2)
/Video/RD3: U8.17 (D3), U10.17 (D3), U12.44 (RD3)
/Video/RD4: U9.2 (D0), U11.2 (D0), U12.45 (RD4)
/Video/RD5: U9.3 (D1), U11.3 (D1), U12.46 (RD5)
/Video/RD6: U9.15 (D2), U11.15 (D2), U12.47 (RD6)
/Video/RD7: U9.17 (D3), U11.17 (D3), U12.48 (RD7)
/Video/VB: Q2.2 (B), R4.1, U12.24 (B)
/Video/VG: Q3.2 (B), R10.1, U12.22 (G)
/Video/VR: Q1.2 (B), R3.1, U12.23 (R)
/Video/VR/~W: RN2.8 (R4), U8.4 (~WE), U9.4 (~WE), U10.4 (~WE), U11.4 (~WE)
/Video/~CAS0: RN2.4 (R2), U8.16 (~CAS), U9.16 (~CAS)
/Video/~CAS1: RN2.6 (R3), U10.16 (~CAS), U11.16 (~CAS)
/Video/~CSYNC: C31.2, J3.19
/Video/~RAS: RN2.2 (R1), U8.5 (~RAS), U9.5 (~RAS), U10.5 (~RAS), U11.5 (~RAS)
/Video/~VCSYNC: R9.2, TP49.1, U12.6 (~CSYNC)
A0: U12.29 (MODE0); also elsewhere on the board
A1: U12.28 (MODE1); also elsewhere on the board
AGND: J3.4; also elsewhere on the board
AUDIO: J3.1, J3.3; also elsewhere on the board
CLK358: TP1.1, U12.8 (CPUCLK/~VDS); also elsewhere on the board
D0: U12.40 (CD0); also elsewhere on the board
D1: U12.39 (CD1); also elsewhere on the board
D2: U12.38 (CD2); also elsewhere on the board
D3: U12.37 (CD3); also elsewhere on the board
D4: U12.36 (CD4); also elsewhere on the board
D5: U12.35 (CD5); also elsewhere on the board
D6: U12.34 (CD6); also elsewhere on the board
D7: U12.32 (CD7); also elsewhere on the board
GND: C17.2, C18.2, C19.2, C20.2, C21.2, C22.2, C25.2, C26.2, C27.2, C29.2, C30.1, J3.5, J3.9, J3.13, J3.14, J3.17, J3.18, J3.21, R3.2, R4.2, R5.2, R6.2, R10.2, R11.2, R12.2, R16.2, U8.1 (~OE), U8.18 (GND), U9.1 (~OE), U9.18 (GND), U10.1 (~OE), U10.18 (GND), U11.1 (~OE), U11.18 (GND), U12.1 (GND), U12.20 (GND/DAC); also elsewhere on the board
unnamed: C17.1, U12.63 (XTAL1), X2.1
unnamed: C18.1, R2.2, X2.2
unnamed: C23.1, R7.1
unnamed: C24.1, R8.1
unnamed: C28.1, R13.1
unnamed: C30.2, U12.33 (VBB)
unnamed: C31.1, R14.1
unnamed: J3.8, JP1.2 (B)
unnamed: J3.16, R17.1
unnamed: Q1.3 (E), R5.1, R7.2
unnamed: Q2.3 (E), R6.1, R8.2
unnamed: Q3.3 (E), R11.1, R13.2
unnamed: Q4.2 (B), R9.1
unnamed: Q4.3 (E), R12.1, R14.2
unnamed: Q5.2 (B), R15.2, R16.1
unnamed: Q5.3 (E), R17.2
unnamed: R2.1, U12.64 (XTAL2)
unnamed: RN2.1, U12.62 (~RAS)
unnamed: RN2.3, U12.61 (~CAS0)
unnamed: RN2.5, U12.60 (~CAS1)
unnamed: RN2.7, U12.57 (R/~W)
VCC: C19.1, C20.1, C21.1, C22.1, C25.1, C26.1, C27.1, C29.1, JP1.1 (A), Q1.1 (C), Q2.1 (C), Q3.1 (C), Q4.1 (C), Q5.1 (C), R15.1, R25.1, U8.9 (VCC), U9.9 (VCC), U10.9 (VCC), U11.9 (VCC), U12.4 (~VRESET), U12.21 (VDD/DAC), U12.27 (~HRESET), U12.58 (VCC); also elsewhere on the board
~CSR: U12.31 (~CSR); also elsewhere on the board
~CSW: U12.30 (~CSW); also elsewhere on the board
~RES: U12.9 (~RESET); also elsewhere on the board
~VINT: U12.25 (~INT); also elsewhere on the board
~WAIT: R25.2, U12.26 (~WAIT); also elsewhere on the board

Notes on the sheet:
Select RGB signals
Switch to AV / SCART

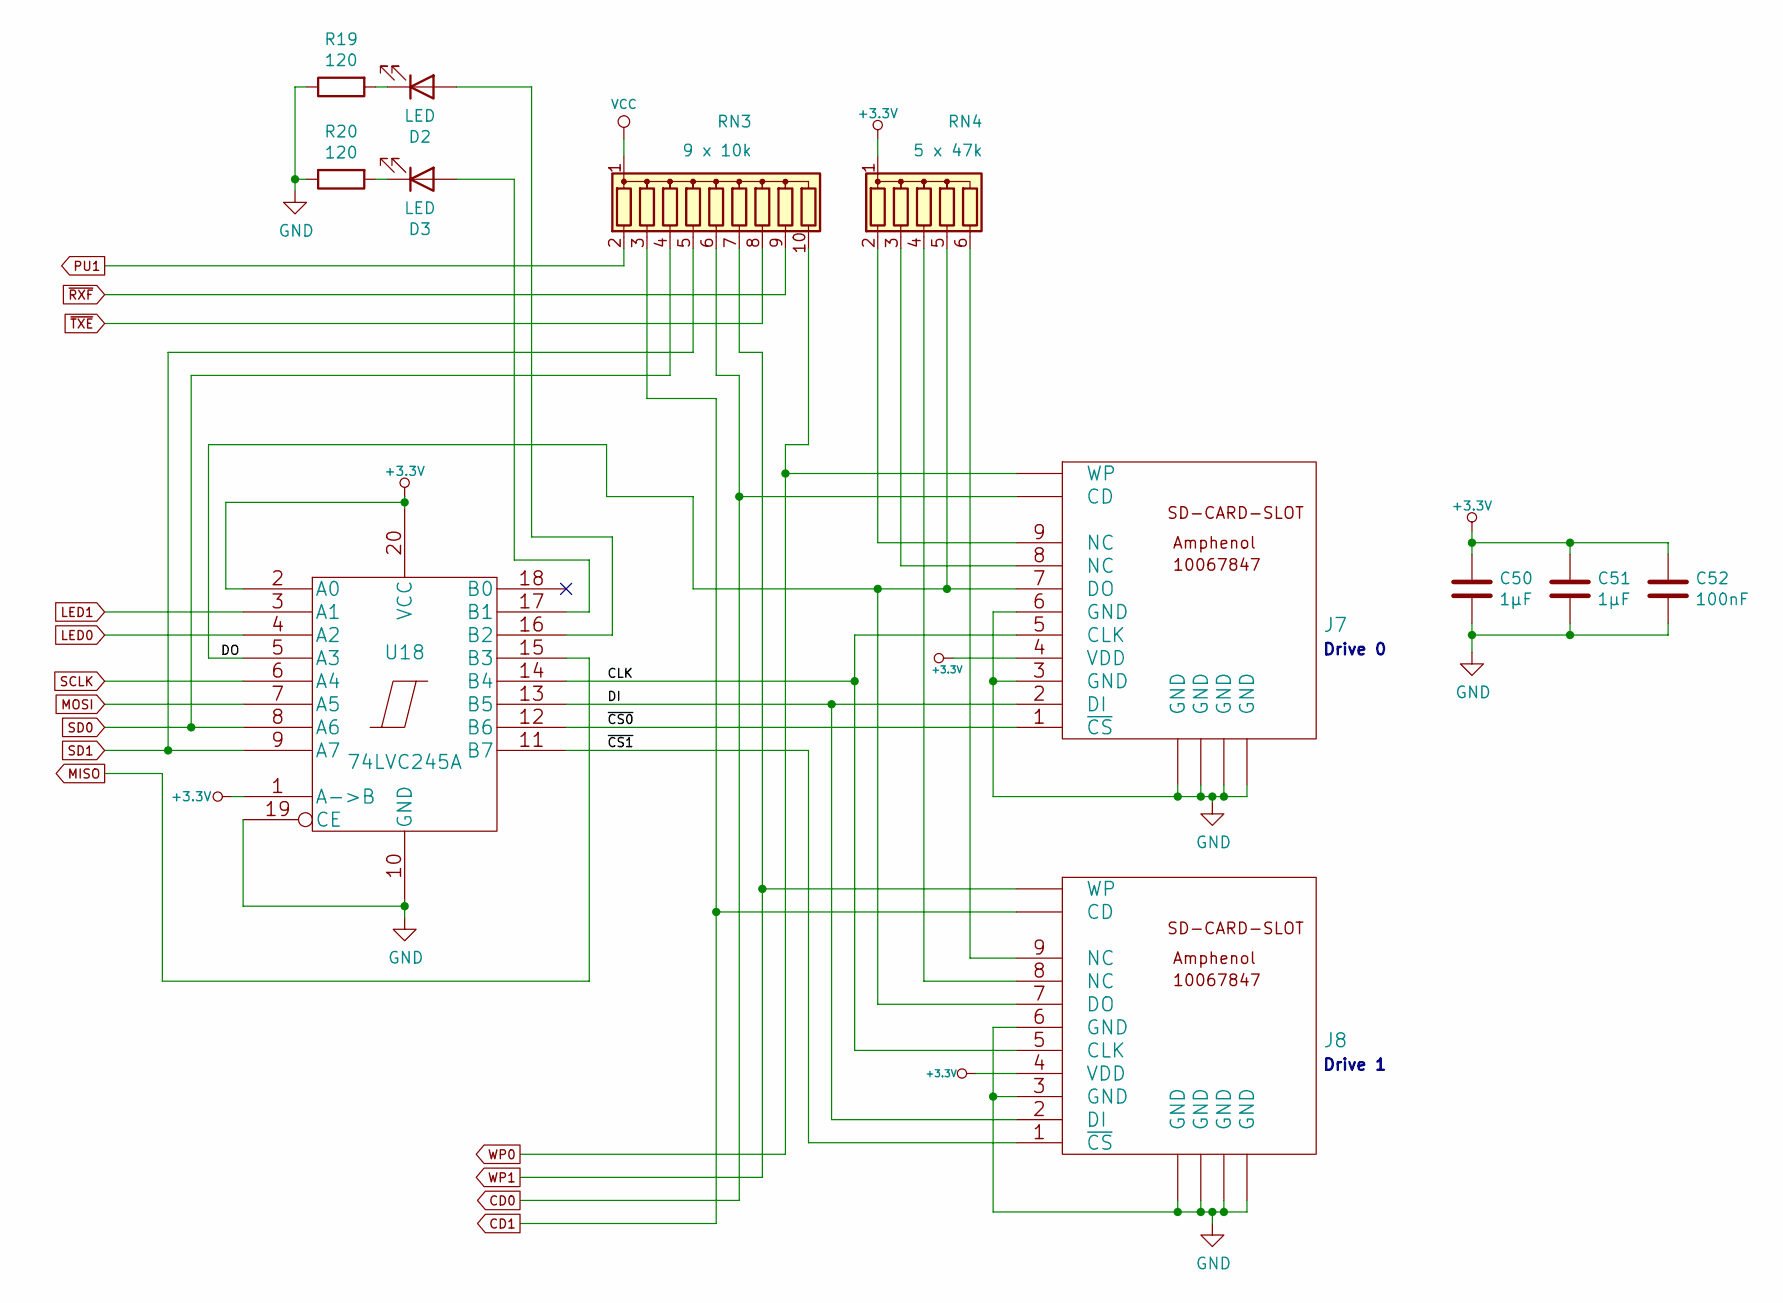
[picture p25: schematic sd-card.sch, kolibri]

Parts:
C50, C51: 1µF; KERKO-5
C52: 100nF; KERKO-5
D2, D3: LED; LED-RND-135-00093
J7, J8: 10067847; SD-SOCKET
R19, R20: 120; R
RN3: 9 x 10k; R_Array_SIP10
RN4: 5 x 47k; R_Array_SIP6
U18: 74LVC245A; DIP-20

Connections:
+3.3V: C50.1, C51.1, C52.1, J7.4 (VDD), J8.4 (VDD), RN4.1 (common), U18.1 (A->B), U18.2 (A0), U18.20 (VCC); also elsewhere on the board
/SD Card/CLK: J7.5 (CLK), J8.5 (CLK), U18.14 (B4)
/SD Card/DI: J7.2 (DI), J8.2 (DI), U18.13 (B5)
/SD Card/DO: J7.7 (DO), J8.7 (DO), RN4.5 (R4), U18.5 (A3)
/SD Card/~CS0: J7.1 (~CS), U18.12 (B6)
/SD Card/~CS1: J8.1 (~CS), U18.11 (B7)
CD0: J7.CD, RN3.6 (R5); also elsewhere on the board
CD1: J8.CD, RN3.3 (R2); also elsewhere on the board
GND: C50.2, C51.2, C52.2, J7.3 (GND), J7.6 (GND), J7.GND1 (GND), J7.GND2 (GND), J7.GND3 (GND), J7.GND4 (GND), J8.3 (GND), J8.6 (GND), J8.GND1 (GND), J8.GND2 (GND), J8.GND3 (GND), J8.GND4 (GND), R19.1, R20.1, U18.10 (GND), U18.19 (CE); also elsewhere on the board
LED0: U18.4 (A2); also elsewhere on the board
LED1: U18.3 (A1); also elsewhere on the board
MISO: U18.15 (B3); also elsewhere on the board
MOSI: U18.7 (A5); also elsewhere on the board
unnamed: D2.1 (K), R19.2
unnamed: D2.2 (A), U18.16 (B2)
unnamed: D3.1 (K), R20.2
unnamed: D3.2 (A), U18.17 (B1)
unnamed: J7.8 (NC), RN4.3 (R2)
unnamed: J7.9 (NC), RN4.2 (R1)
unnamed: J8.8 (NC), RN4.4 (R3)
unnamed: J8.9 (NC), RN4.6 (R5)
PU1: RN3.2 (R1); also elsewhere on the board
SCLK: U18.6 (A4); also elsewhere on the board
SD0: RN3.4 (R3), U18.8 (A6); also elsewhere on the board
SD1: RN3.5 (R4), U18.9 (A7); also elsewhere on the board
VCC: RN3.1 (common); also elsewhere on the board
WP0: J7.WP, RN3.10 (R9); also elsewhere on the board
WP1: J8.WP, RN3.7 (R6); also elsewhere on the board
~RXF: RN3.9 (R8); also elsewhere on the board
~TXE: RN3.8 (R7); also elsewhere on the board

Notes on the sheet:
Drive 0
Drive 1

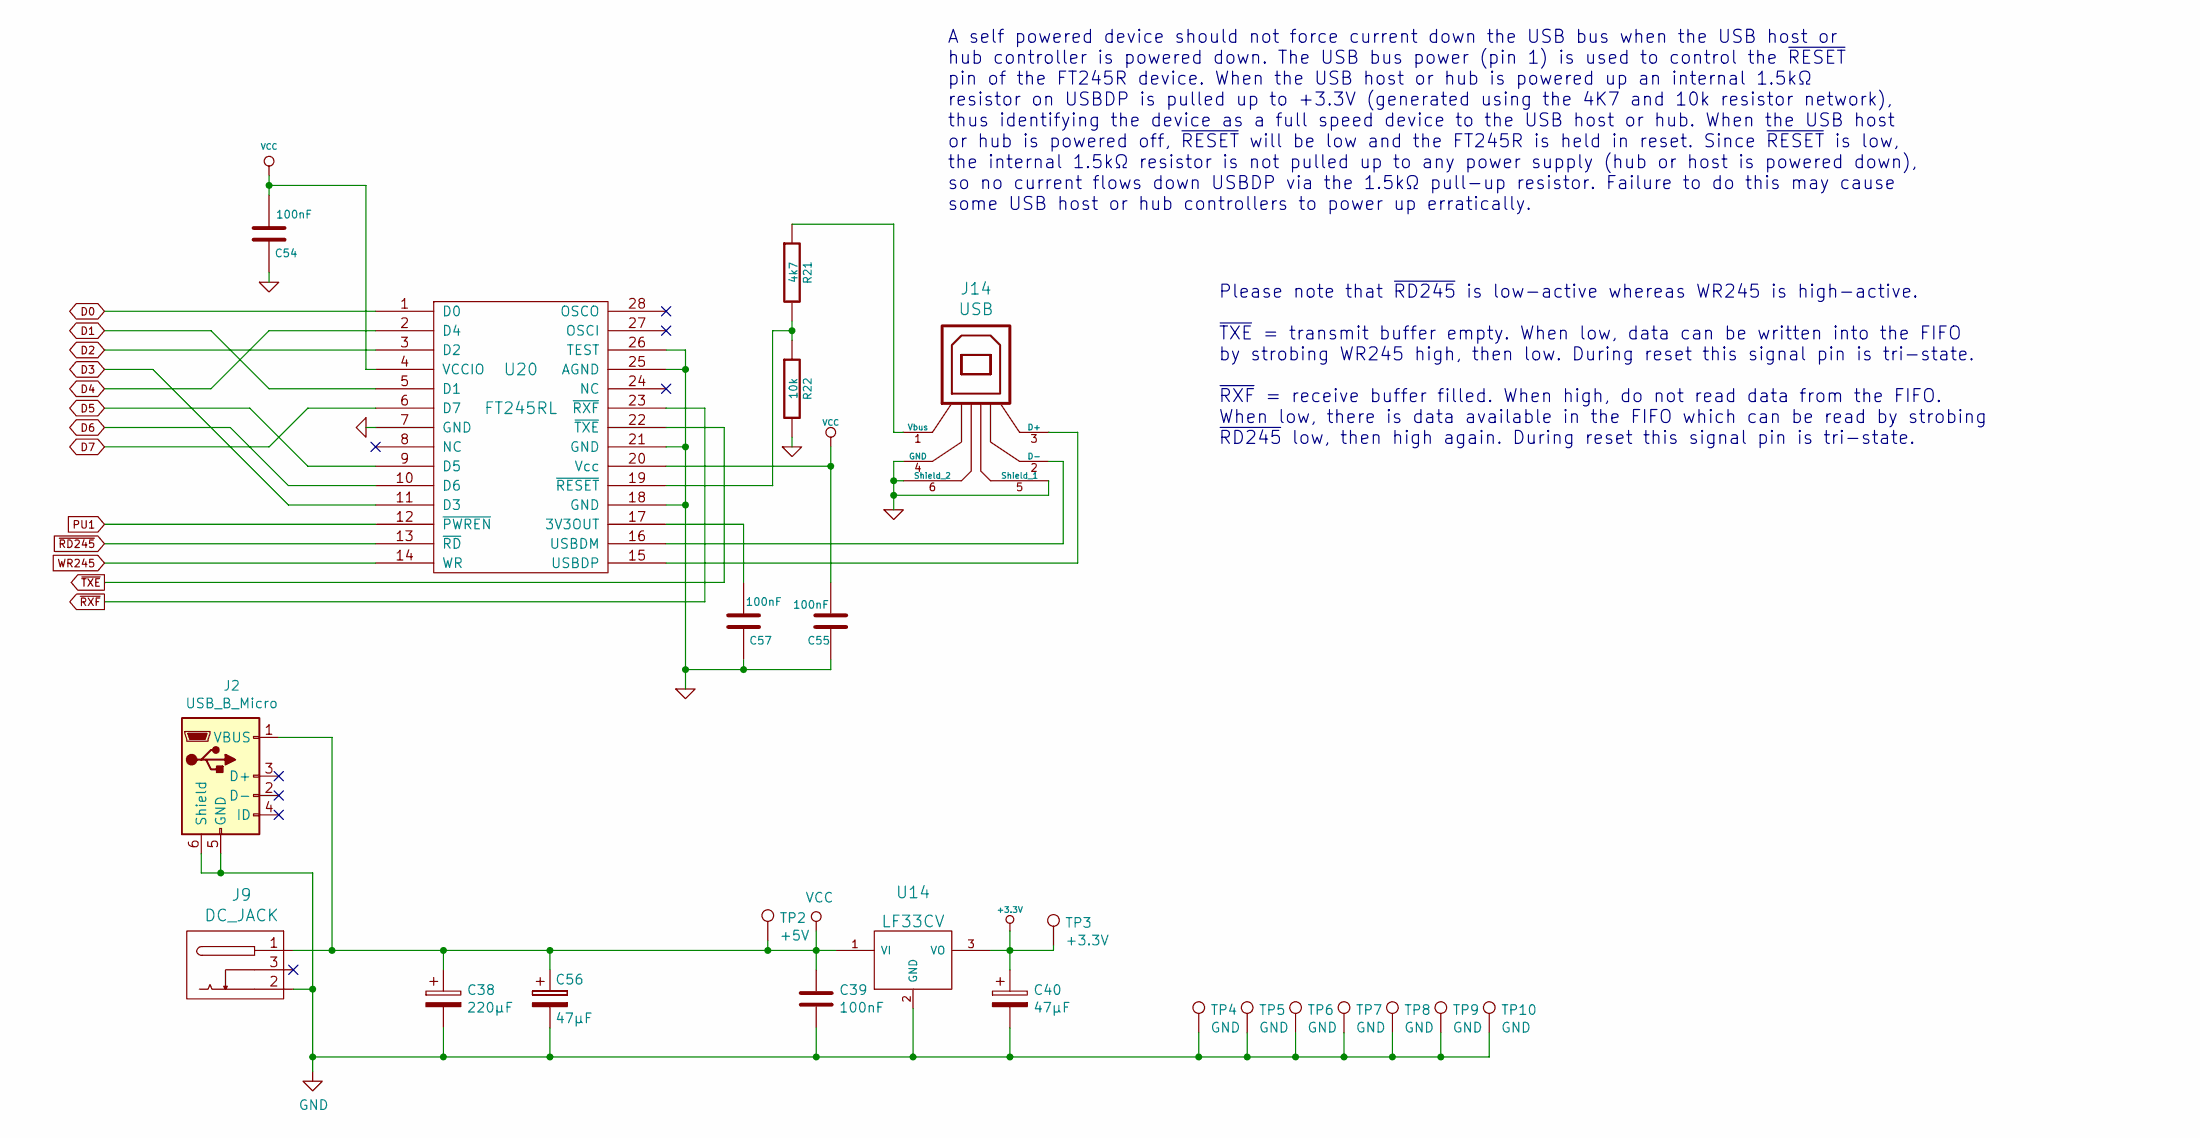
[picture p26: schematic usbser.sch, kolibri]

Parts:
C38: 220µF; CP-2-6
C39, C54, C55, C57: 100nF; KERKO-5
C40, C56: 47µF; CP-2-5
J2: USB_B_Micro; micro-usb-amphenol-10103594
J9: DC_JACK; JACK_ALIM
J14: USB; USB_B
R21: 4k7; R
R22: 10k; R
TP2: +5V; PINTST
TP3: +3.3V; PINTST
TP4, TP5, TP6, TP7, TP8, TP9, TP10: GND; PINTST
U14: LF33CV; TO-220-HORIZ
U20: FT245RL; SSOP-28

Connections:
+3.3V: C40.1, TP3.1, U14.3 (VO); also elsewhere on the board
D0: U20.1 (D0); also elsewhere on the board
D1: U20.5 (D1); also elsewhere on the board
D2: U20.3 (D2); also elsewhere on the board
D3: U20.11 (D3); also elsewhere on the board
D4: U20.2 (D4); also elsewhere on the board
D5: U20.9 (D5); also elsewhere on the board
D6: U20.10 (D6); also elsewhere on the board
D7: U20.6 (D7); also elsewhere on the board
GND: C38.2, C39.2, C40.2, C54.1, C55.1, C56.2, C57.1, J2.5 (GND), J2.6 (Shield), J9.2, J14.4 (GND), J14.5 (Shield_1), J14.6 (Shield_2), R22.2, TP4.1, TP5.1, TP6.1, TP7.1, TP8.1, TP9.1, TP10.1, U14.2 (GND), U20.7 (GND), U20.18 (GND), U20.21 (GND), U20.25 (AGND), U20.26 (TEST); also elsewhere on the board
unnamed: C57.2, U20.17 (3V3OUT)
unnamed: J14.1 (Vbus), R21.1
unnamed: J14.2 (D-), U20.16 (USBDM)
unnamed: J14.3 (D+), U20.15 (USBDP)
unnamed: R21.2, R22.1, U20.19 (~RESET)
PU1: U20.12 (~PWREN); also elsewhere on the board
VCC: C38.1, C39.1, C54.2, C55.2, C56.1, J2.1 (VBUS), J9.1, TP2.1, U14.1 (VI), U20.4 (VCCIO), U20.20 (Vcc); also elsewhere on the board
WR245: U20.14 (WR); also elsewhere on the board
~RD245: U20.13 (~RD); also elsewhere on the board
~RXF: U20.23 (~RXF); also elsewhere on the board
~TXE: U20.22 (~TXE); also elsewhere on the board

Notes on the sheet:
Please note that ~RD245~ is low-active whereas WR245 is high-active. ~TXE~ = transmit buffer empty. When low, data can be written into the FIFO by strobing WR245 high, then low. During reset this signal pin is tri-state. ~RXF~ = receive buffer filled. When high, do not read data from the FIFO. When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
A self powered device should not force current down the USB bus when the USB host or hub controller is powered down. The USB bus power (pin 1) is used to control the ~RESET~ pin of the FT245R device. When the USB host or hub is powered up an internal 1.5kΩ resistor on USBDP is pulled up to +3.3V (g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
