nils-eilers/kolibri/hardware/kicad/main.kicad_pcb

## KiCad design hardware/kicad/main.kicad_pcb (continued)

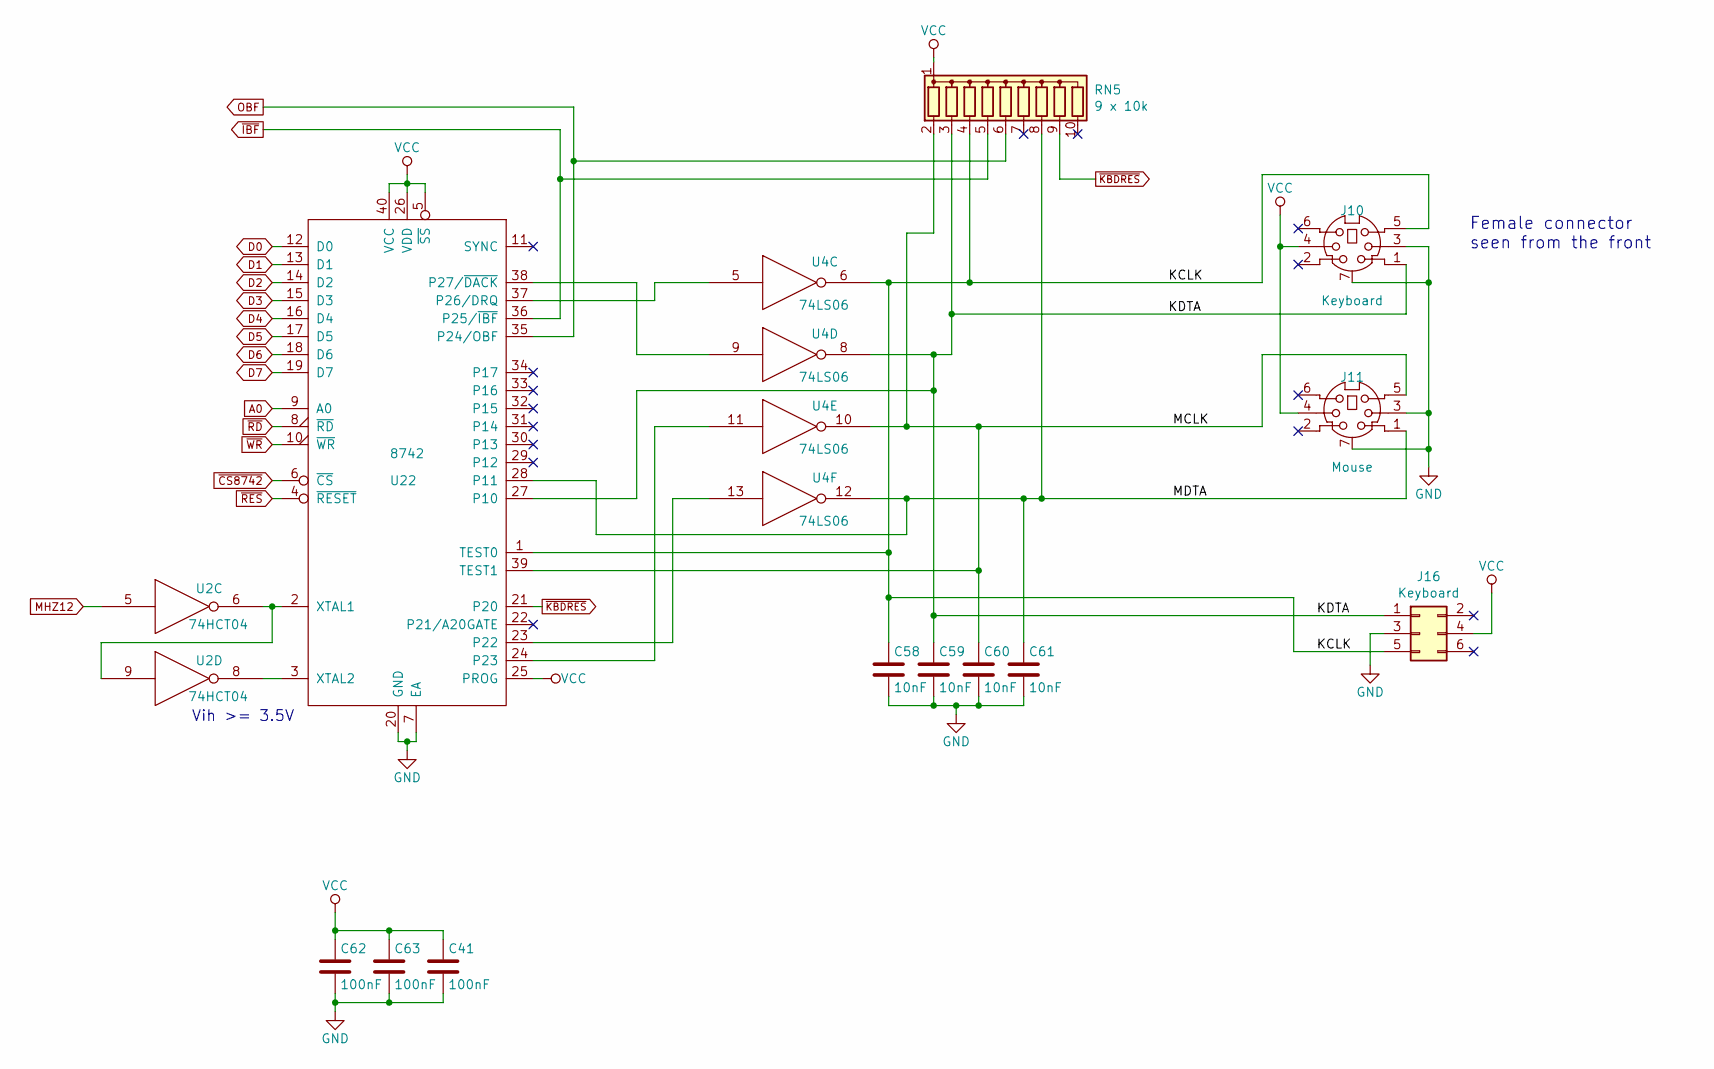
[picture p27: schematic ps2.sch, kolibri]

Parts:
C41, C62, C63: 100nF; KERKO-5
C58, C59, C60, C61: 10nF; KERKO-5
J10: Keyboard; EB-DIOS-M06
J11: Mouse; EB-DIOS-M06
J16: Keyboard; IDC-Header_2x03_P2.54mm_Vertical
RN5: 9 x 10k; R_Array_SIP10
U2: 74HCT04; DIP-14
U4: 74LS06; DIP-14
U22: 8742; DIP-40

Connections:
/Keyboard, Mouse/KCLK: C58.1, J10.5, J16.5, RN5.4 (R3), U4.6, U22.1 (TEST0)
/Keyboard, Mouse/KDTA: C59.1, J10.1, J16.1, RN5.3 (R2), U4.8, U22.27 (P10)
/Keyboard, Mouse/MCLK: C60.1, J11.5, RN5.2 (R1), U4.10, U22.39 (TEST1)
/Keyboard, Mouse/MDTA: C61.1, J11.1, RN5.8 (R7), U4.12, U22.28 (P11)
A0: U22.9 (A0); also elsewhere on the board
D0: U22.12 (D0); also elsewhere on the board
D1: U22.13 (D1); also elsewhere on the board
D2: U22.14 (D2); also elsewhere on the board
D3: U22.15 (D3); also elsewhere on the board
D4: U22.16 (D4); also elsewhere on the board
D5: U22.17 (D5); also elsewhere on the board
D6: U22.18 (D6); also elsewhere on the board
D7: U22.19 (D7); also elsewhere on the board
GND: C41.2, C58.2, C59.2, C60.2, C61.2, C62.2, C63.2, J10.3, J10.7 (Shell), J11.3, J11.7 (Shell), J16.3, U2.7 (GND), U4.7 (GND), U22.7 (EA), U22.20 (GND); also elsewhere on the board
MHZ12: U2.5; also elsewhere on the board
unnamed: U2.6, U2.9, U22.2 (XTAL1)
unnamed: U2.8, U22.3 (XTAL2)
unnamed: U4.13, U22.23 (P22)
unnamed: U4.11, U22.24 (P23)
unnamed: U4.5, U22.37 (P26/DRQ)
unnamed: U4.9, U22.38 (P27/~DACK)
OBF: RN5.6 (R5), U22.35 (P24/OBF); also elsewhere on the board
VCC: C41.1, C62.1, C63.1, J10.4, J11.4, J16.4, RN5.1 (common), U2.14 (VCC), U4.14 (VCC), U22.5 (~SS~), U22.25 (PROG), U22.26 (VDD), U22.40 (VCC); also elsewhere on the board
~CS8742: U22.6 (~CS); also elsewhere on the board
~IBF: RN5.5 (R4), U22.36 (P25/~IBF); also elsewhere on the board
~KBDRES: RN5.9 (R8), U22.21 (P20); also elsewhere on the board
~RD: U22.8 (~RD~); also elsewhere on the board
~RES: U22.4 (~RESET~); also elsewhere on the board
~WR: U22.10 (~WR~); also elsewhere on the board

Notes on the sheet:
Vih >= 3.5V
Female connector seen from the front

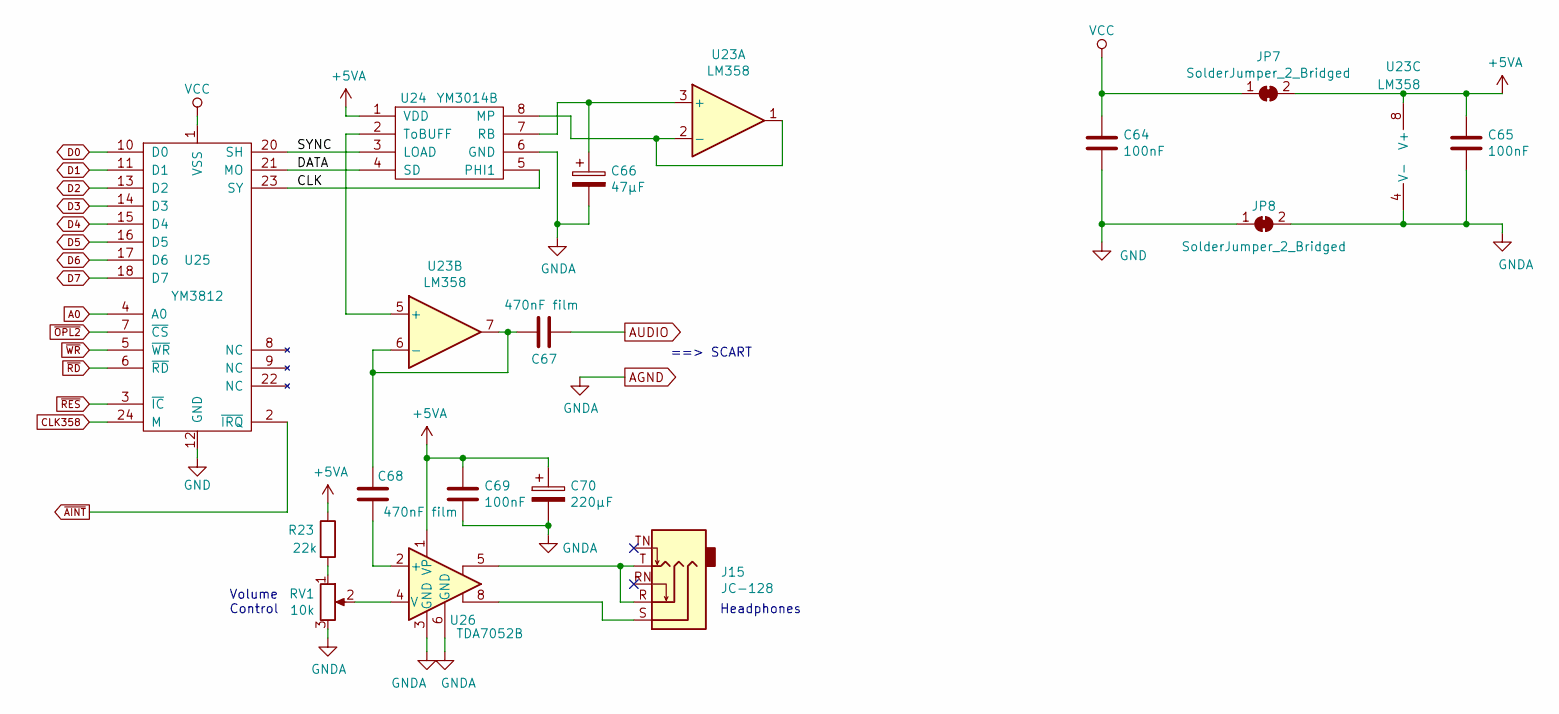
[picture p28: schematic opl2.sch, kolibri]

Parts:
C64, C65, C69: 100nF; KERKO-5
C66: 47µF; CP-2-5
C67, C68: 470nF film; C-FILM-5
C70: 220µF; CP-2-6
J15: JC-128
JP7, JP8: SolderJumper_2_Bridged; SolderJumper-2_P1.3mm_Bridged_RoundedPad1.0x1.5mm
R23: 22k; R
RV1: 10k; PT10H-THUMBWHEEL
U23: LM358; DIP-8
U24: YM3014B; DIP-8
U25: YM3812; DIP-24
U26: TDA7052B; DIP-8

Connections:
+5VA: C65.1, C69.1, C70.1, JP7.2 (B), R23.1, U23.8 (V+), U24.1 (VDD), U26.1 (VP)
/OPL2 sound/CLK: U24.5 (PHI1), U25.23 (SY)
/OPL2 sound/DATA: U24.4 (SD), U25.21 (MO)
/OPL2 sound/SYNC: U24.3 (LOAD), U25.20 (SH)
A0: U25.4 (A0); also elsewhere on the board
AGND: C65.2, C66.2, C69.2, C70.2, JP8.2 (B), RV1.3, U23.4 (V-), U24.6 (GND), U26.3 (GND), U26.6 (GND); also elsewhere on the board
AUDIO: C67.1; also elsewhere on the board
CLK358: U25.24 (M); also elsewhere on the board
D0: U25.10 (D0); also elsewhere on the board
D1: U25.11 (D1); also elsewhere on the board
D2: U25.13 (D2); also elsewhere on the board
D3: U25.14 (D3); also elsewhere on the board
D4: U25.15 (D4); also elsewhere on the board
D5: U25.16 (D5); also elsewhere on the board
D6: U25.17 (D6); also elsewhere on the board
D7: U25.18 (D7); also elsewhere on the board
GND: C64.2, JP8.1 (A), U25.12 (GND); also elsewhere on the board
unnamed: C66.1, U23.3 (+), U24.7 (RB)
unnamed: C67.2, C68.2, U23.6 (-), U23.7
unnamed: C68.1, U26.2 (+)
unnamed: J15.R, J15.T, U26.5
unnamed: J15.S, U26.8
unnamed: R23.2, RV1.1
unnamed: RV1.2, U26.4 (V)
unnamed: U23.1, U23.2 (-), U24.8 (MP)
unnamed: U23.5 (+), U24.2 (ToBUFF)
VCC: C64.1, JP7.1 (A), U25.1 (VSS); also elsewhere on the board
~AINT: U25.2 (~IRQ); also elsewhere on the board
~OPL2: U25.7 (~CS); also elsewhere on the board
~RD: U25.6 (~RD); also elsewhere on the board
~RES: U25.3 (~IC); also elsewhere on the board
~WR: U25.5 (~WR); also elsewhere on the board

Notes on the sheet:
==> SCART
Headphones
Volume Control

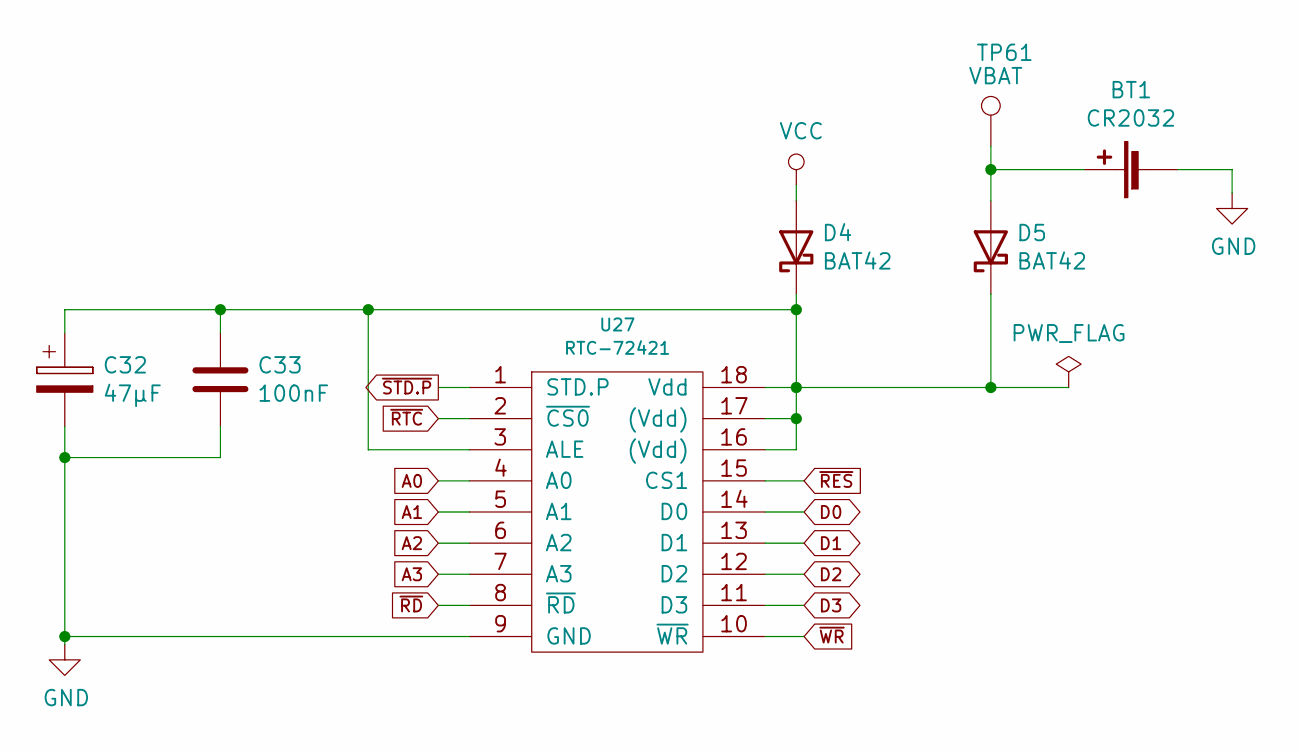
[picture p29: schematic rtc.sch, kolibri]

Parts:
BT1: CR2032; KZH20SMD
C32: 47µF; CP-2-5
C33: 100nF; KERKO-5
D4, D5: BAT42; DO35
TP61: VBAT; PINTST
U27: RTC-72421; DIP-18

Connections:
A0: U27.4 (A0); also elsewhere on the board
A1: U27.5 (A1); also elsewhere on the board
A2: U27.6 (A2); also elsewhere on the board
A3: U27.7 (A3); also elsewhere on the board
D0: U27.14 (D0); also elsewhere on the board
D1: U27.13 (D1); also elsewhere on the board
D2: U27.12 (D2); also elsewhere on the board
D3: U27.11 (D3); also elsewhere on the board
GND: BT1.2 (-), C32.2, C33.2, U27.9 (GND); also elsewhere on the board
unnamed: BT1.1 (+), D5.2 (A), TP61.1
unnamed: C32.1, C33.1, D4.1 (K), D5.1 (K), U27.3 (ALE), U27.16 ((Vdd)), U27.17 ((Vdd)), U27.18 (Vdd)
VCC: D4.2 (A); also elsewhere on the board
~RD: U27.8 (~RD); also elsewhere on the board
~RES: U27.15 (CS1); also elsewhere on the board
~RTC: U27.2 (~CS0); also elsewhere on the board
~STD.P: U27.1 (STD.P); also elsewhere on the board
~WR: U27.10 (~WR); also elsewhere on the board

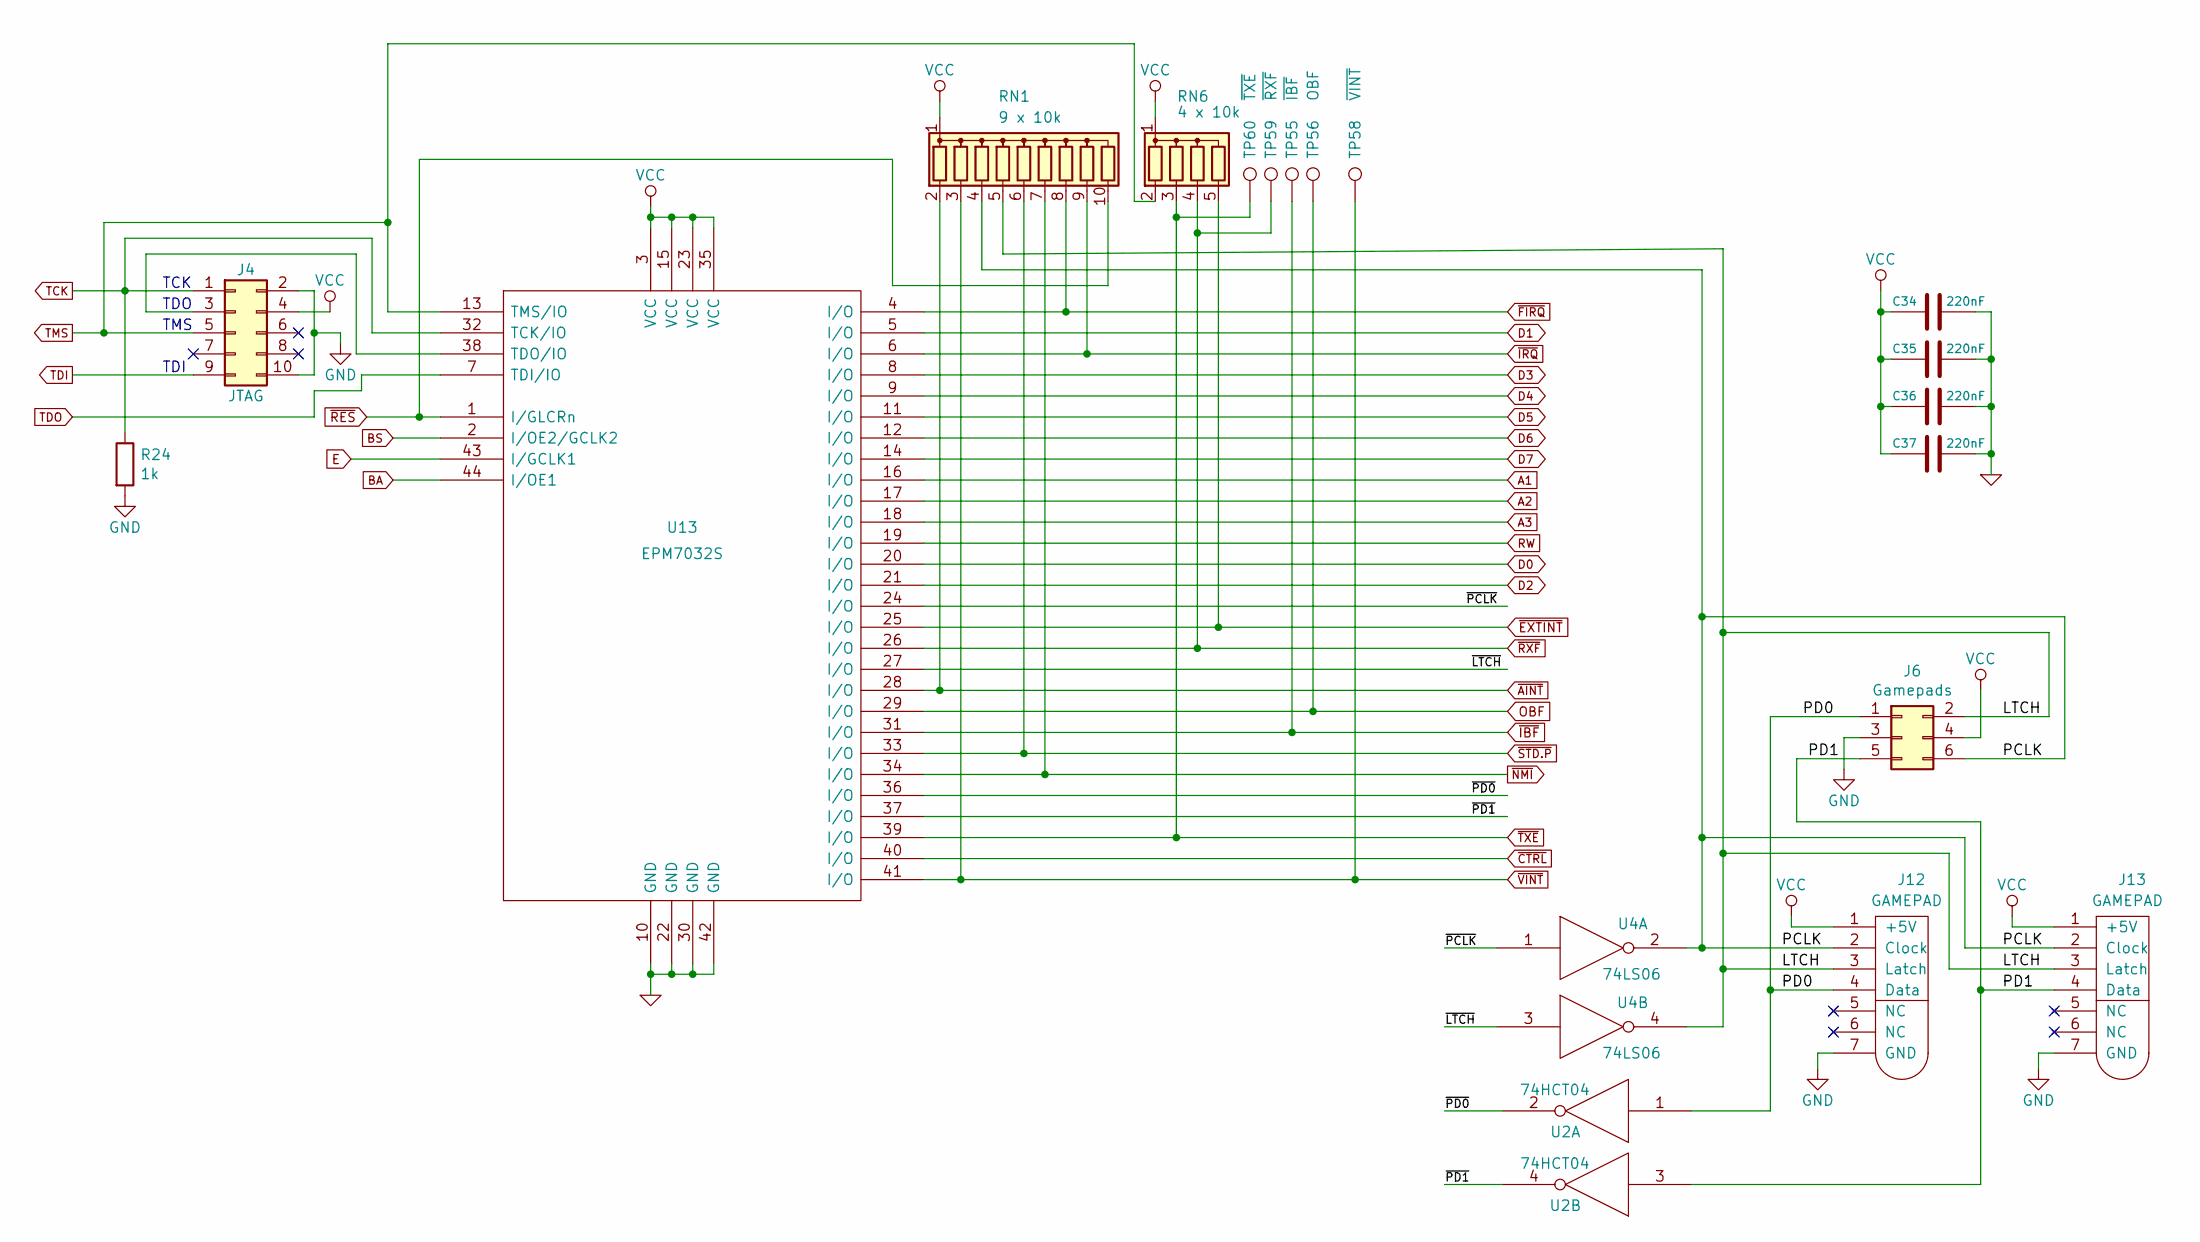
[picture p30: schematic game-int.sch, kolibri]

Parts:
C34, C35, C36, C37: 220nF; KERKO-5
J4: JTAG; WSL10G
J6: Gamepads; WSL_6W
J12, J13: GAMEPAD
R24: 1k; R
RN1: 9 x 10k; R_Array_SIP10
RN6: 4 x 10k; R_Array_SIP5
TP55: ~IBF; PINTST
TP56: OBF; PINTST
TP58: ~VINT; PINTST
TP59: ~RXF; PINTST
TP60: ~TXE; PINTST
U2: 74HCT04; DIP-14
U4: 74LS06; DIP-14
U13: EPM7032S; PLCC-44

Connections:
/Gamepads and Interrupts/LTCH: J6.2, J12.3 (Latch), J13.3 (Latch), RN1.5 (R4), U4.4
/Gamepads and Interrupts/PCLK: J6.6, J12.2 (Clock), J13.2 (Clock), RN1.4 (R3), U4.2
/Gamepads and Interrupts/PD0: J6.1, J12.4 (Data), U2.1
/Gamepads and Interrupts/PD1: J6.5, J13.4 (Data), U2.3
/Gamepads and Interrupts/~LTCH: U4.3, U13.27 (I/O)
/Gamepads and Interrupts/~PCLK: U4.1, U13.24 (I/O)
/Gamepads and Interrupts/~PD0: U2.2, U13.36 (I/O)
/Gamepads and Interrupts/~PD1: U2.4, U13.37 (I/O)
A1: U13.16 (I/O); also elsewhere on the board
A2: U13.17 (I/O); also elsewhere on the board
A3: U13.18 (I/O); also elsewhere on the board
BA: U13.44 (I/OE1); also elsewhere on the board
BS: U13.2 (I/OE2/GCLK2); also elsewhere on the board
D0: U13.20 (I/O); also elsewhere on the board
D1: U13.5 (I/O); also elsewhere on the board
D2: U13.21 (I/O); also elsewhere on the board
D3: U13.8 (I/O); also elsewhere on the board
D4: U13.9 (I/O); also elsewhere on the board
D5: U13.11 (I/O); also elsewhere on the board
D6: U13.12 (I/O); also elsewhere on the board
D7: U13.14 (I/O); also elsewhere on the board
E: U13.43 (I/GCLK1); also elsewhere on the board
GND: C34.2, C35.2, C36.2, C37.2, J4.2, J4.10, J6.3, J12.7 (GND), J13.7 (GND), R24.2, U2.7 (GND), U4.7 (GND), U13.10 (GND), U13.22 (GND), U13.30 (GND), U13.42 (GND); also elsewhere on the board
unnamed: J4.3, U13.38 (TDO/IO)
OBF: TP56.1, U13.29 (I/O); also elsewhere on the board
RW: U13.19 (I/O)
TCK: J4.1, R24.1, U13.32 (TCK/IO); also elsewhere on the board
TDI: J4.9; also elsewhere on the board
TDO: U13.7 (TDI/IO); also elsewhere on the board
TMS: J4.5, RN6.2 (R1), U13.13 (TMS/IO); also elsewhere on the board
VCC: C34.1, C35.1, C36.1, C37.1, J4.4, J6.4, J12.1 (+5V), J13.1 (+5V), RN1.1 (common), RN6.1 (common), U2.14 (VCC), U4.14 (VCC), U13.3 (VCC), U13.15 (VCC), U13.23 (VCC), U13.35 (VCC); also elsewhere on the board
~AINT: RN1.2 (R1), U13.28 (I/O); also elsewhere on the board
~CTRL: U13.40 (I/O); also elsewhere on the board
~EXTINT: RN6.5 (R4), U13.25 (I/O); also elsewhere on the board
~FIRQ: RN1.8 (R7), U13.4 (I/O); also elsewhere on the board
~IBF: TP55.1, U13.31 (I/O); also elsewhere on the board
~IRQ: RN1.9 (R8), U13.6 (I/O); also elsewhere on the board
~NMI: RN1.7 (R6), U13.34 (I/O); also elsewhere on the board
~RES: RN1.10 (R9), U13.1 (I/GLCRn); also elsewhere on the board
~RXF: RN6.4 (R3), TP59.1, U13.26 (I/O); also elsewhere on the board
~STD.P: RN1.6 (R5), U13.33 (I/O); also elsewhere on the board
~TXE: RN6.3 (R2), TP60.1, U13.39 (I/O); also elsewhere on the board
~VINT: RN1.3 (R2), TP58.1, U13.41 (I/O); also elsewhere on the board

Notes on the sheet:
TCK
TDO
TMS
TDI

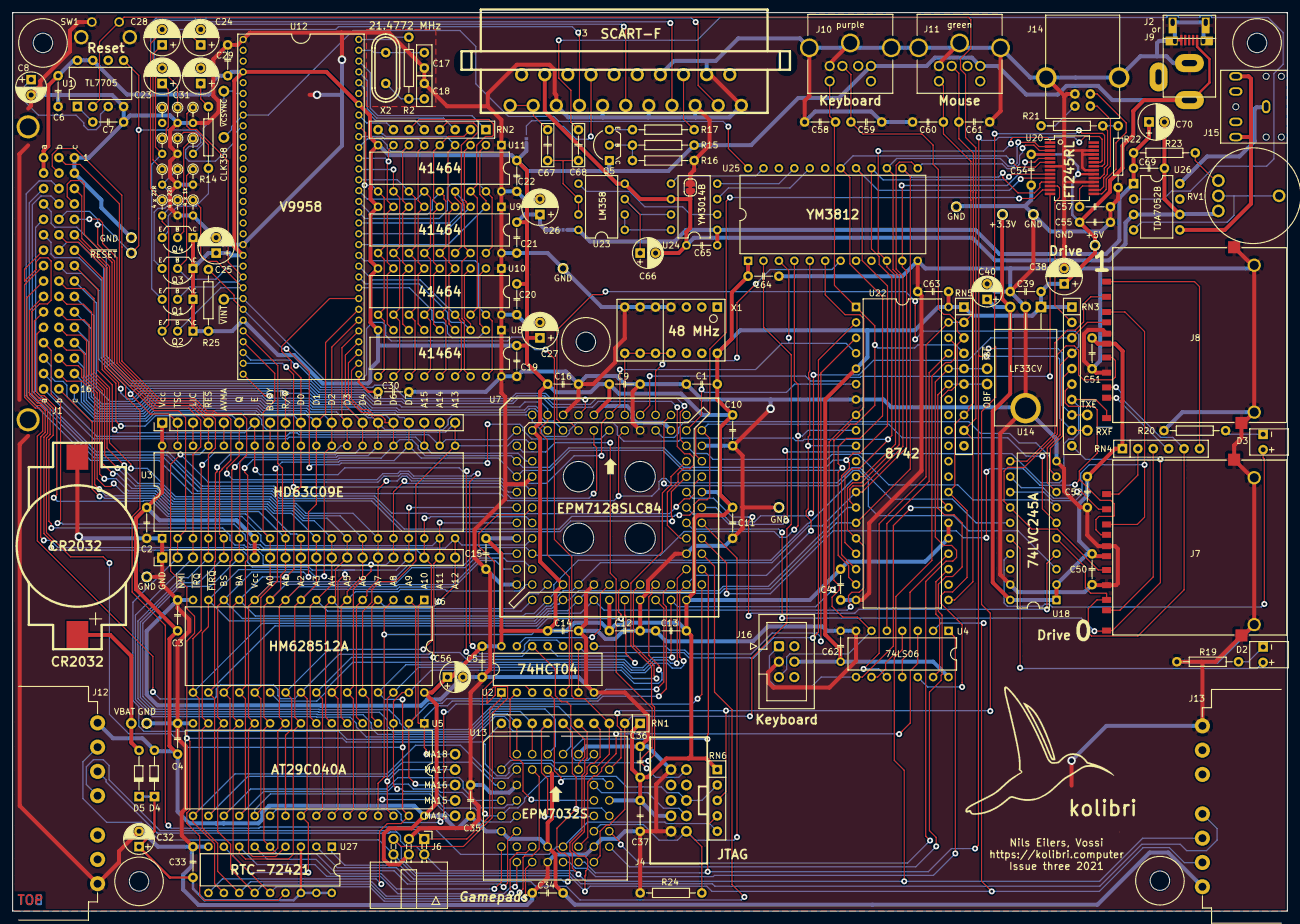
[picture p31: board main.kicad_pcb from above]

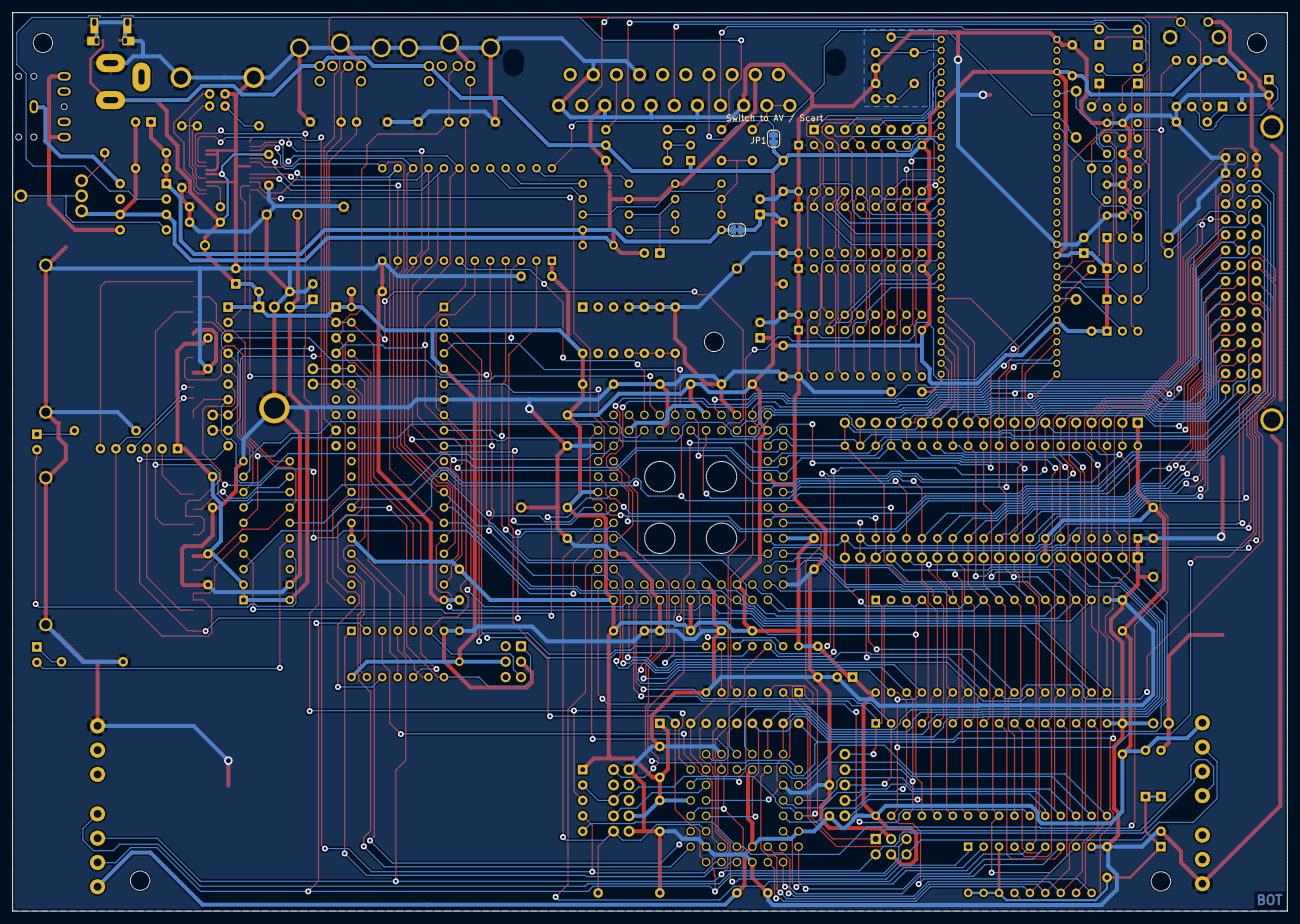
[picture p32: board main.kicad_pcb from below]

Board: 2 copper layers, 210.0 x 148.0 mm, 175 parts (2 on the bottom side), 196 nets.

Other parts of the board:
MH1, MH2, MH3, MH4, MH5: M3x6 + DI 8MM; M3-MOUNTHOLE
