nils-eilers/kolibri/(commit log)

2020-02-13 as9 language = assembly
2020-02-16 fix CMPR bug in emulator
    [6809.c]
2020-02-16 fix trap and div0 errors in emu
    [6809.c]
2020-02-17 manual: make the code example executable
    All code examples should actually be executable.
    It is clear to an experienced assembly programmer
    that the former example was just meant as an
    example but a less experienced person might
    just copy and paste that example and experience
    a failire because of the string constant
    being executed as code.
2020-02-17 Add .vimrc settings for .as9 source files
    - Tab size is 8
    - expand tabs to spaces
    - show line numbers
    - enable syntax highlighting for 6309 assembly
2020-02-20 added Insert
2020-02-24 switch off debug watch addresses in ncurses mode
2020-03-14 add missing zero register to emu
    [6809.c]
2020-03-15 added color VDP.AS9 - insert+delete not finished
2020-03-20 insert with color table fnished and tested
2020-04-06 Load S-Record file if boot switch is pressed
2020-04-06 CPLD: add some missing chip select signals
    [kolibri.v]
2020-04-09 Add Wannabe Power Chime
    Pressing Ctrl-G while editing will ring
    the bell also
2020-04-15 Print 5bit offsets as signed decimal
2020-04-15 fix TIM bug in emulator
    [6809.c]
2020-04-15 Fix boot switch handling
2020-04-15 emu: add option -b to handle boot switch
    -b --> boot switch pressed
    -b+ --> boot switch pressed
    -b- --> boot switch not pressed
    -b option not given (the default) --> boot switch not pressed
2020-04-17 Add SPI bus support
2020-04-17 optimize spi.as9
2020-04-18 optimize spi.as9 again
2020-04-18 SPI mode 0 (CPHA=0, CPOL=0) is the proper setting to control MMC/SDC
2020-04-25 CPLD: add missing pin assignment for 68882 chip select
    [kolibri.v]
2020-04-25 CPLD: enable/disable MMU map mode
    Note: chip select signals are still missing in map mode
    [kolibri.v]
2021-05-02 New PCB: Issue Two
    [cpu.sch, fpu.sch, game-int.sch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]
2021-05-04 Some corrections for issue two
    [clock.v, kolibri.v]
2021-05-06 Add Verilog project for second CPLD (Gamepads, Interrupts)
2021-05-06 Switch license to public domain/unlicense.org
2021-05-17 Fix CPLD pin assignments
2021-05-18 Clarify generation of chip select signals
    Doesn't create binary changes
    [kolibri.v]
2021-05-18 Rework I/O defs, especially for FT245 signals
    [cpld2.v]
2021-05-22 Ignore KiCad backup files
2021-05-22 Ignore KiCad autosaved files
2021-05-22 Make LEDs work
    [cpu.sch, game-int.sch, main.kicad_pcb, ps2.sch, sd-card.sch, video.sch]
2021-05-23 Build a JTAG chain
    Thats just one JTAG connector for both CPLDs
    [cpu.sch, main.kicad_pcb]
2021-05-25 New PCB: Issue Three
    [cpu.sch, game-int.sch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]
2021-05-26 Update schematics to issue three board
    [cpu.sch, game-int.sch, main.sch, opl2.sch, ps2.sch, rtc.sch, sd-card.sch, usbser.sch]
2021-05-26 Update BILL OF MATERIALS for issue three board
